GimenezCA/proyecto-mecatr-nica-gimenez/1000251209.jpg

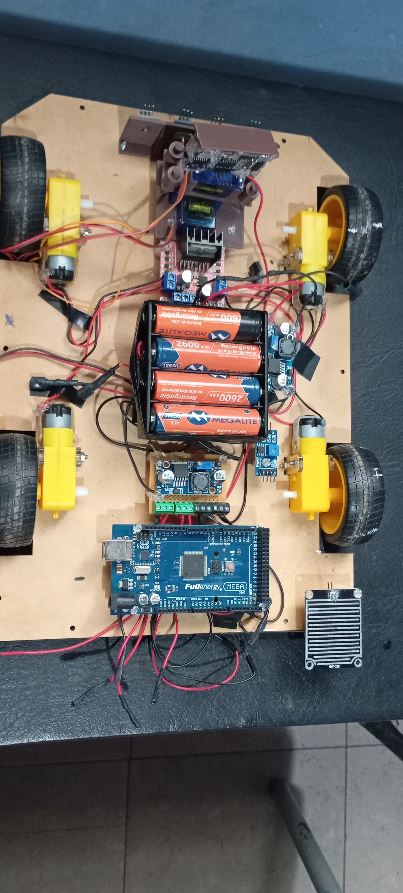
1000251209.jpg
