GimenezCA/proyecto-mecatr-nica-gimenez/1000251601.jpg

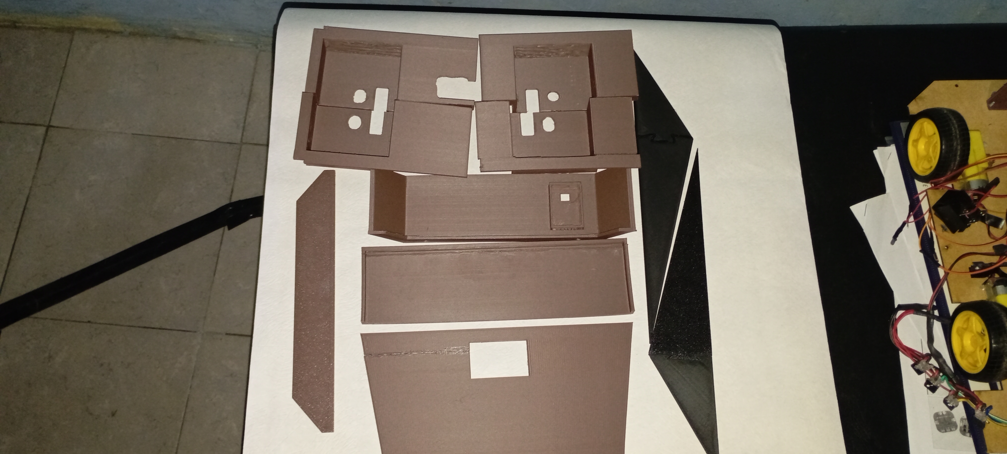
1000251601.jpg
