GimenezCA/proyecto-mecatr-nica-gimenez/README.md

# proyecto-mecatr-nica-gimenez



## Vehículo de vigilancia remoto



Vehiculo de pequeño para seguridad de predios, autonomo, con interfaz para visión y manejo por un usuario.
