GimenezCA/proyecto-mecatr-nica-gimenez/1000251196.jpg

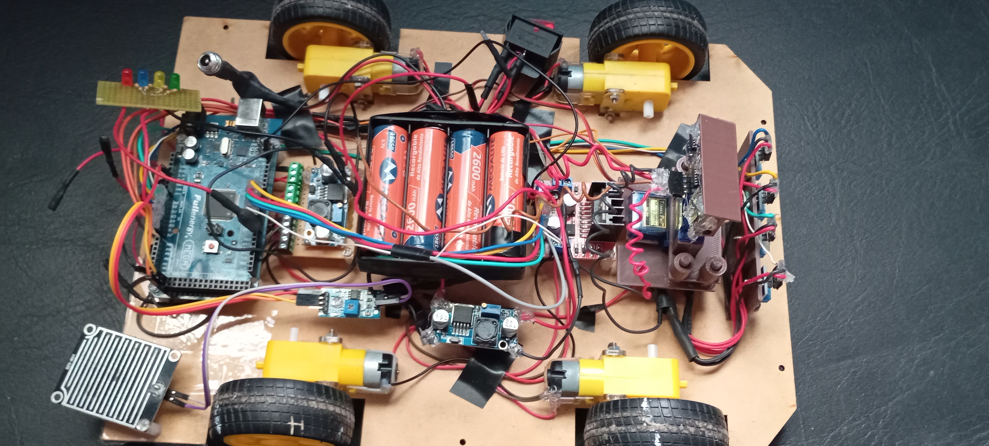
1000251196.jpg
