GimenezCA/proyecto-mecatr-nica-gimenez/1000251207 (1).jpg

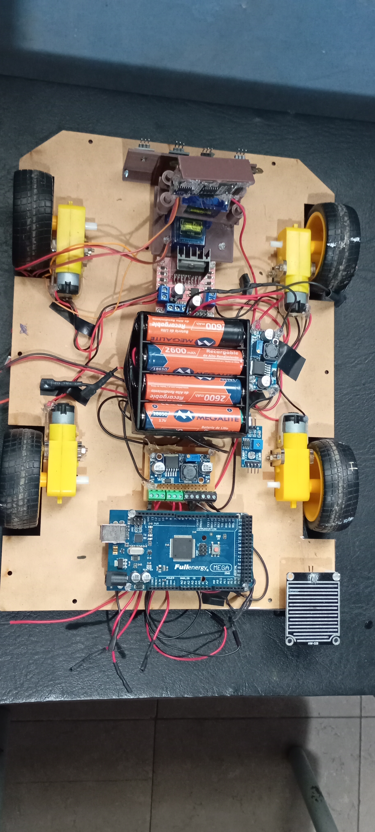
1000251207 (1).jpg
