GimenezCA/proyecto-mecatr-nica-gimenez/IMG-20250530-WA0015.jpg

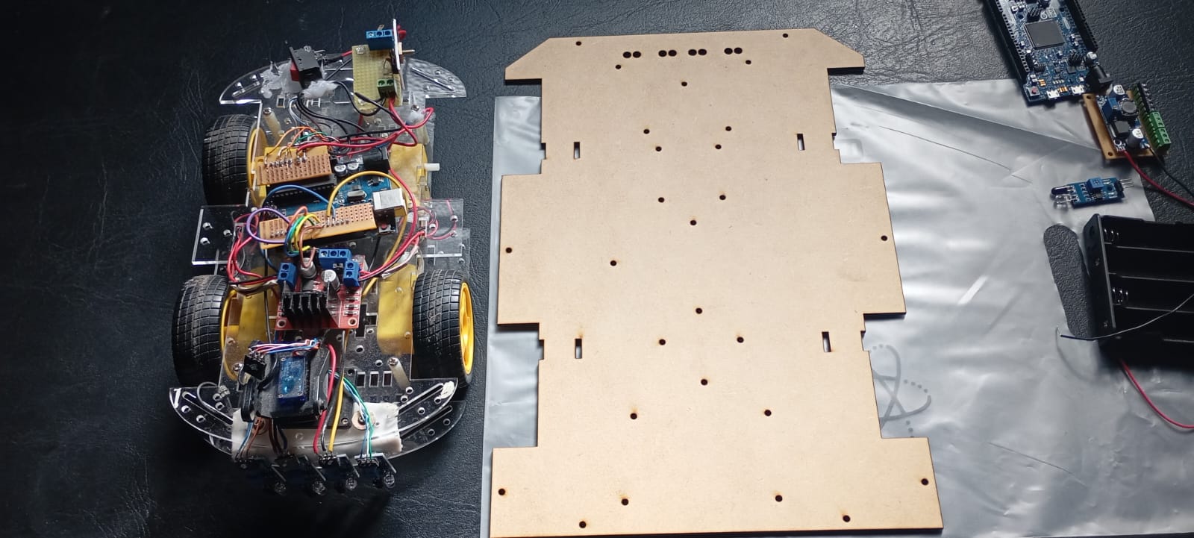
IMG-20250530-WA0015.jpg
