GimenezCA/proyecto-mecatr-nica-gimenez/IMG-20250530-WA0023.jpeg

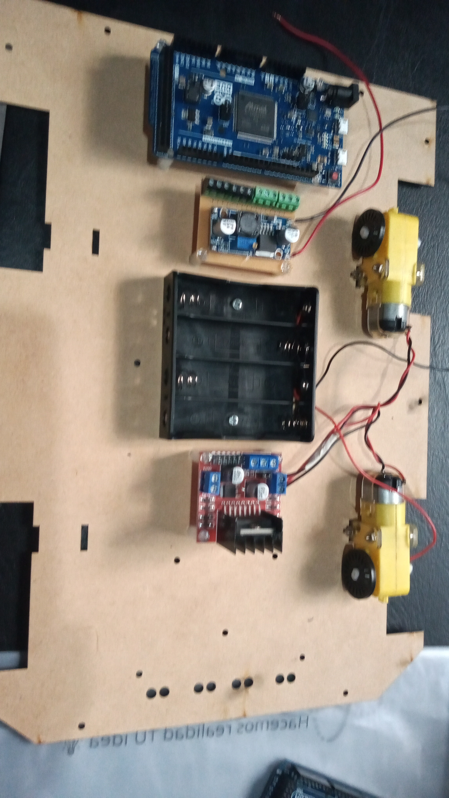
IMG-20250530-WA0023.jpeg
