GimenezCA/proyecto-mecatr-nica-gimenez/IMG_20221026_105854754.jpg

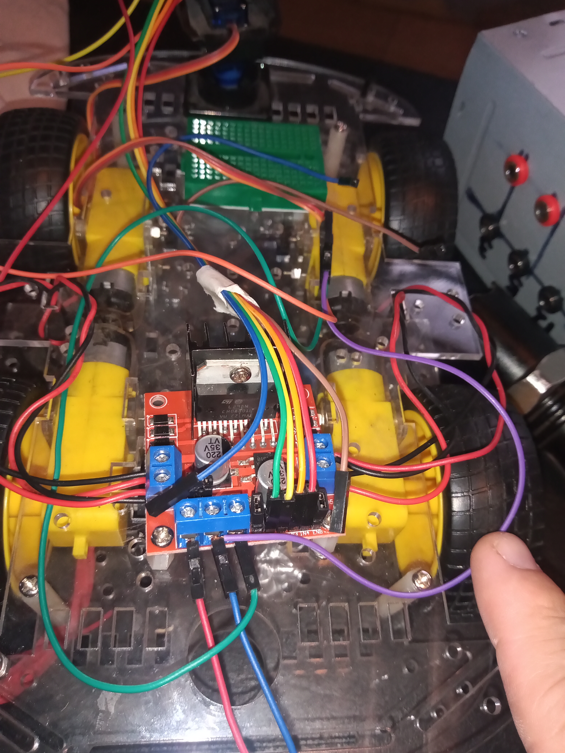
IMG_20221026_105854754.jpg
