GimenezCA/proyecto-mecatr-nica-gimenez/IMG_20221026_125409257.jpg

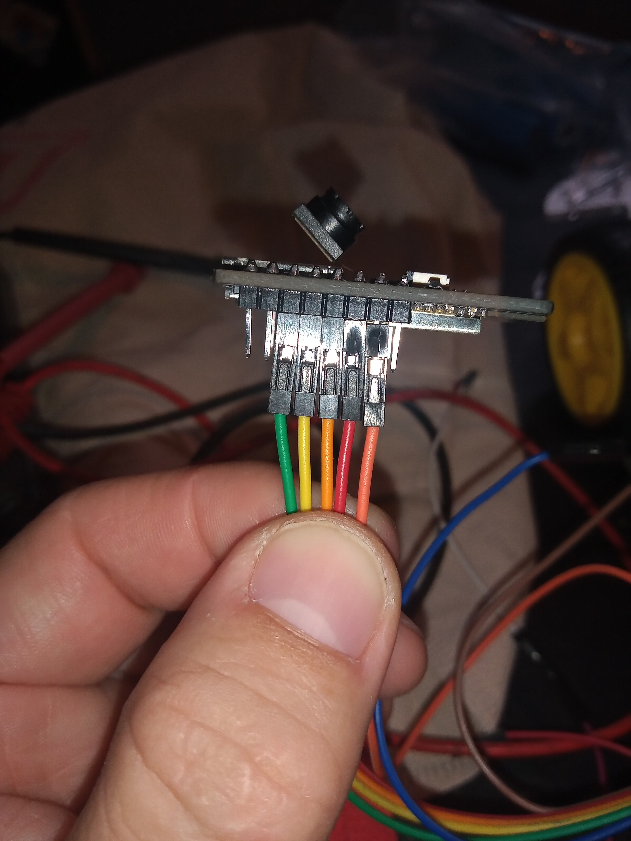
IMG_20221026_125409257.jpg
