GimenezCA/proyecto-mecatr-nica-gimenez/IMG_20250531_104836443.jpg

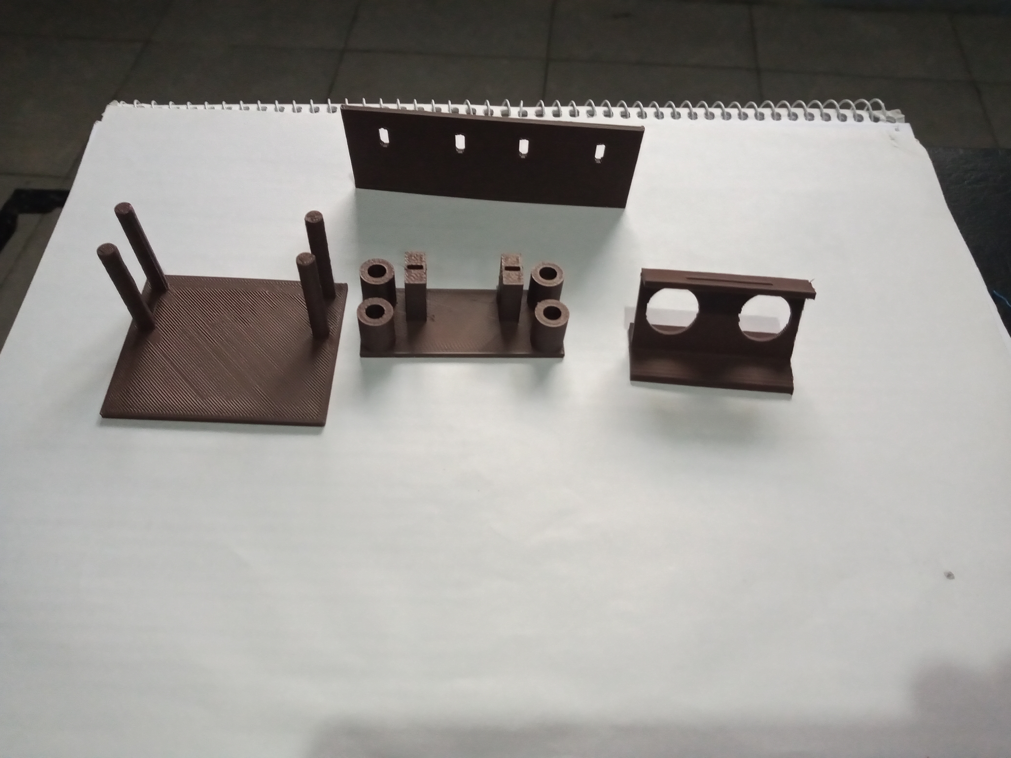
IMG_20250531_104836443.jpg
