GimenezCA/proyecto-mecatr-nica-gimenez/II-Planos_vistas_cotas_placabase_carcasa_conjuntoelevador.pdf

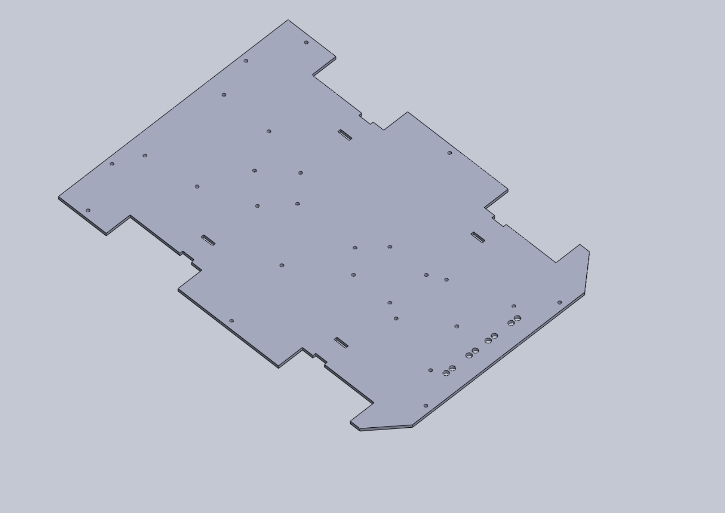
[picture p69: page 1]
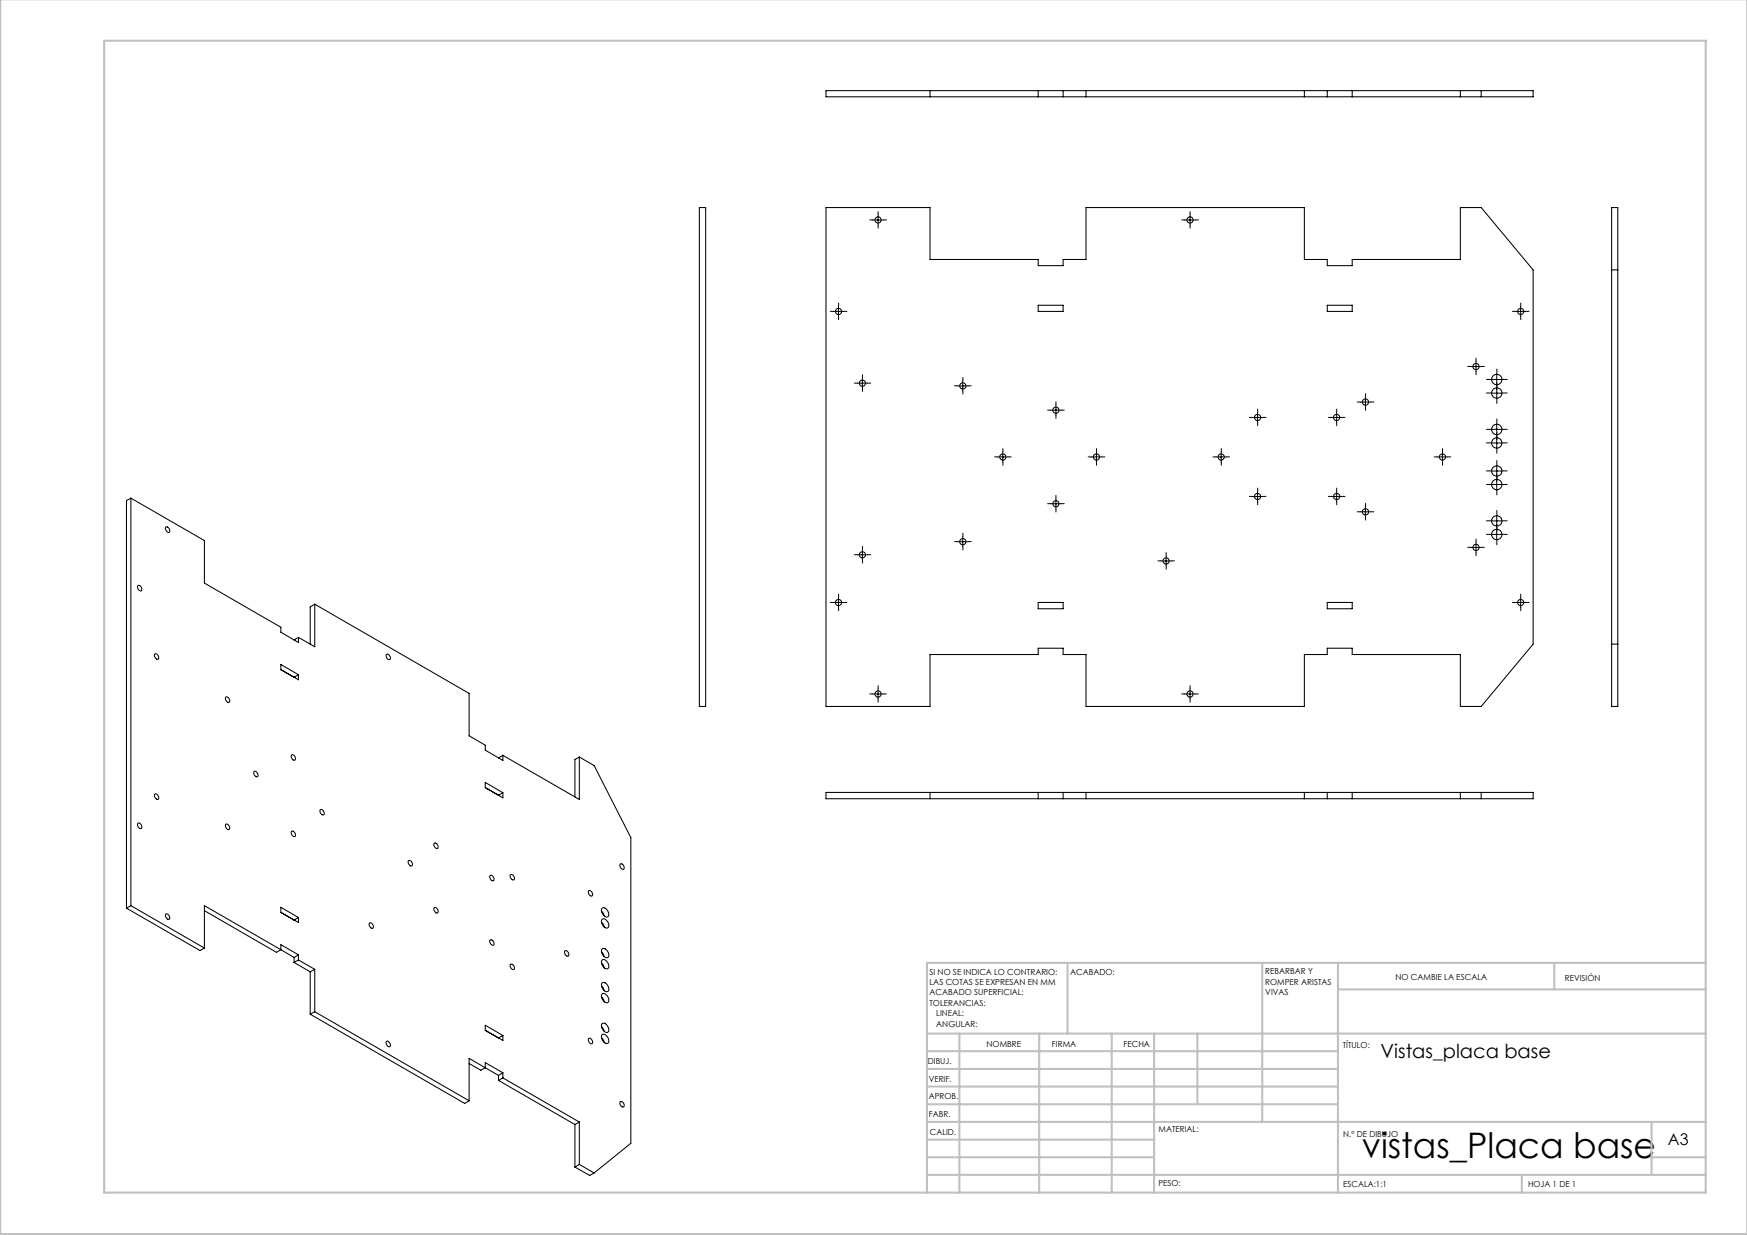
[picture p70: page 2]
ESCALA:1:1; HOJA 1 DE 1; NO CAMBIE LA ESCALA; REVISIÓN; REBARBAR Y ROMPER ARISTAS VIVAS; SI NO SE INDICA LO CONTRARIO:; ACABADO:

LAS COTAS SE EXPRESAN EN MM
ACABADO SUPERFICIAL:
TOLERANCIAS:
LINEAL:
ANGULAR:

NOMBRE | FIRMA | FECHA | | | | TÍTULO: Vistas_placa base
CALID. | | | | MATERIAL: | vistas_Placa base PESO: N.º DE DIBUJO | A3

DIBUJ.
VERIF.
APROB.
FABR.

50 52

12

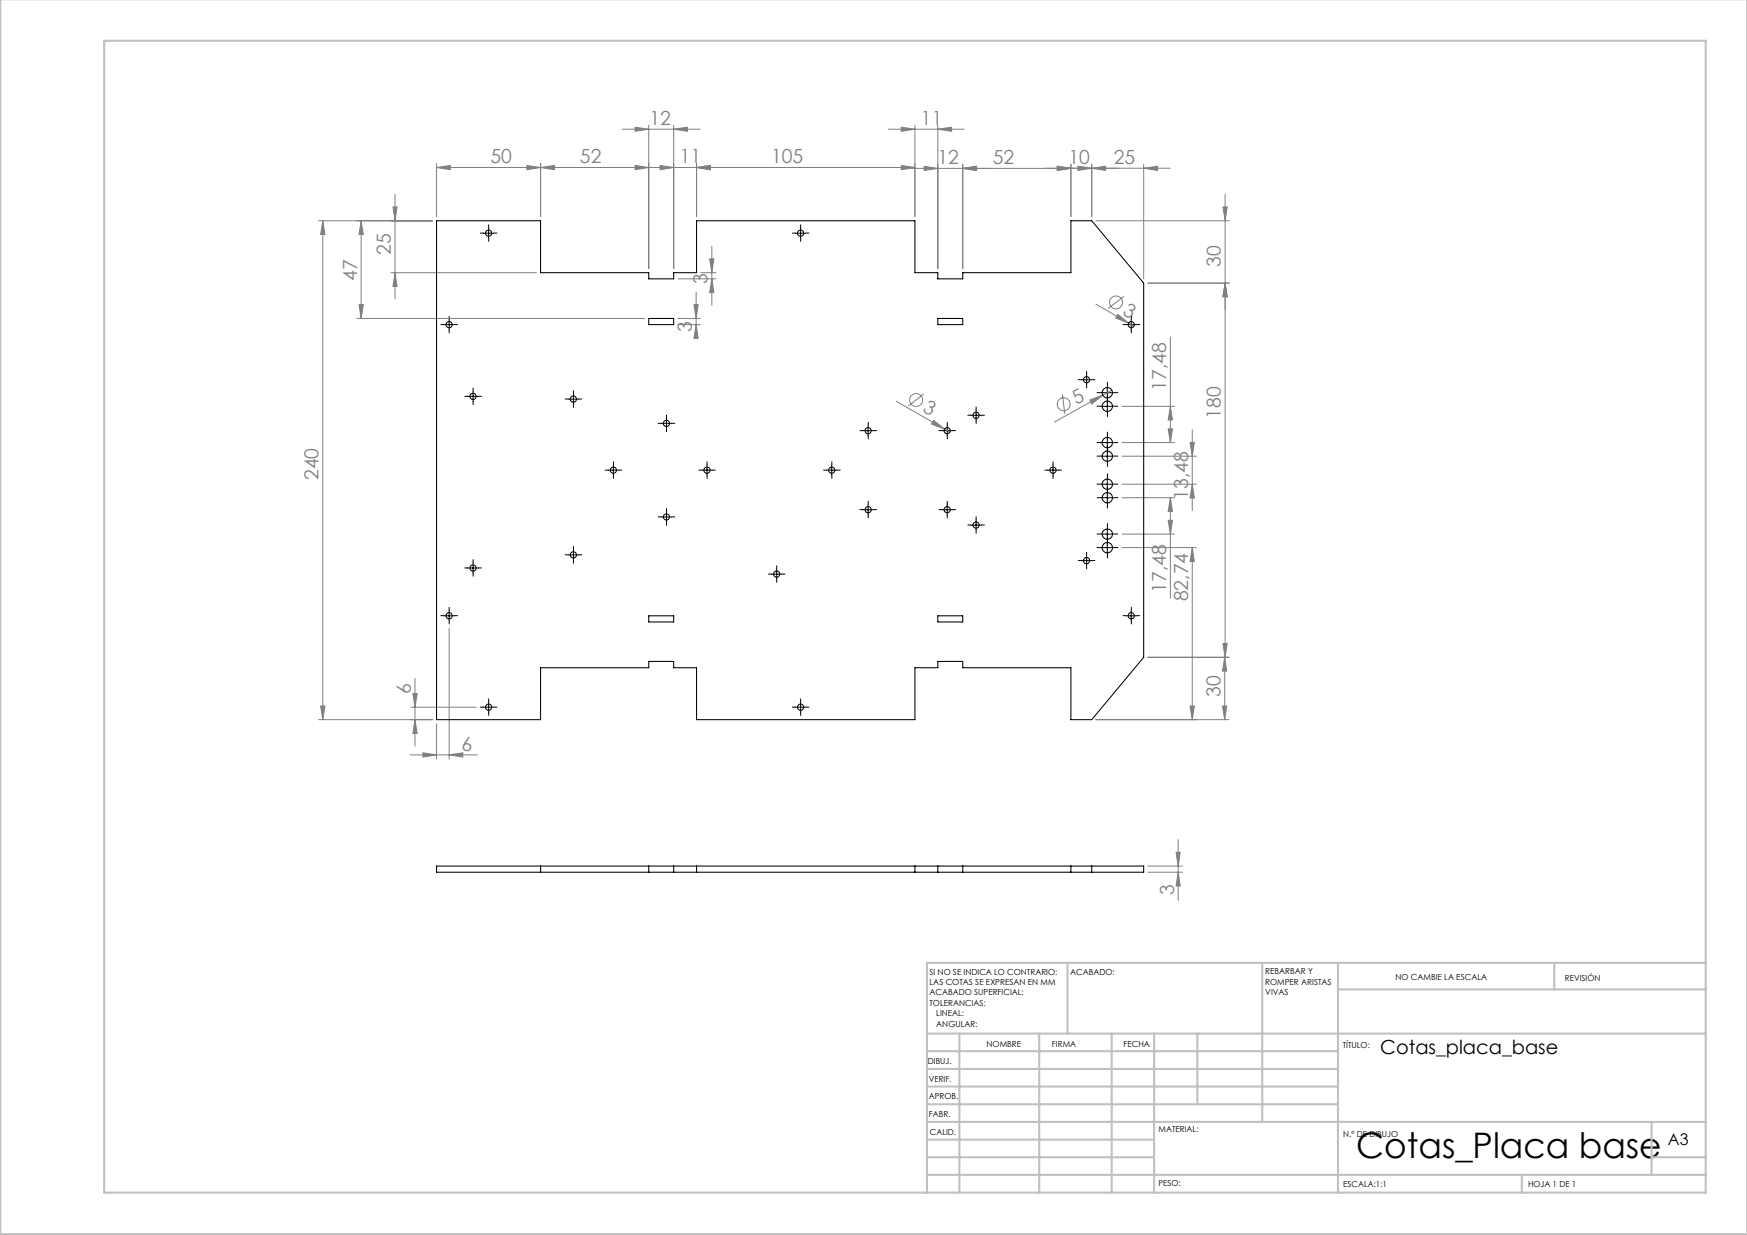
[picture p71: page 3]
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

LAS COTAS SE EXPRESAN EN MM
ACABADO SUPERFICIAL:
TOLERANCIAS:
LINEAL:
ANGULAR:

NOMBRE | FIRMA | FECHA | | | Cotas_placa_base TÍTULO:

DIBUJ.
VERIF.
APROB.
FABR.

MATERIAL: | Cotas_Placa base PESO:

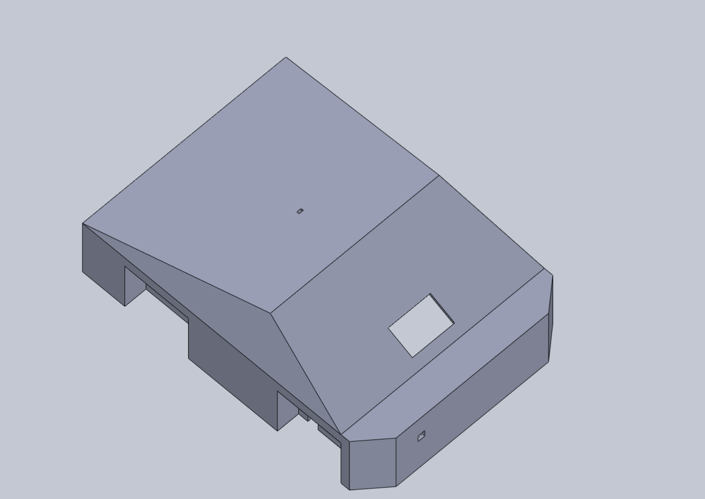
[picture p72: page 4]
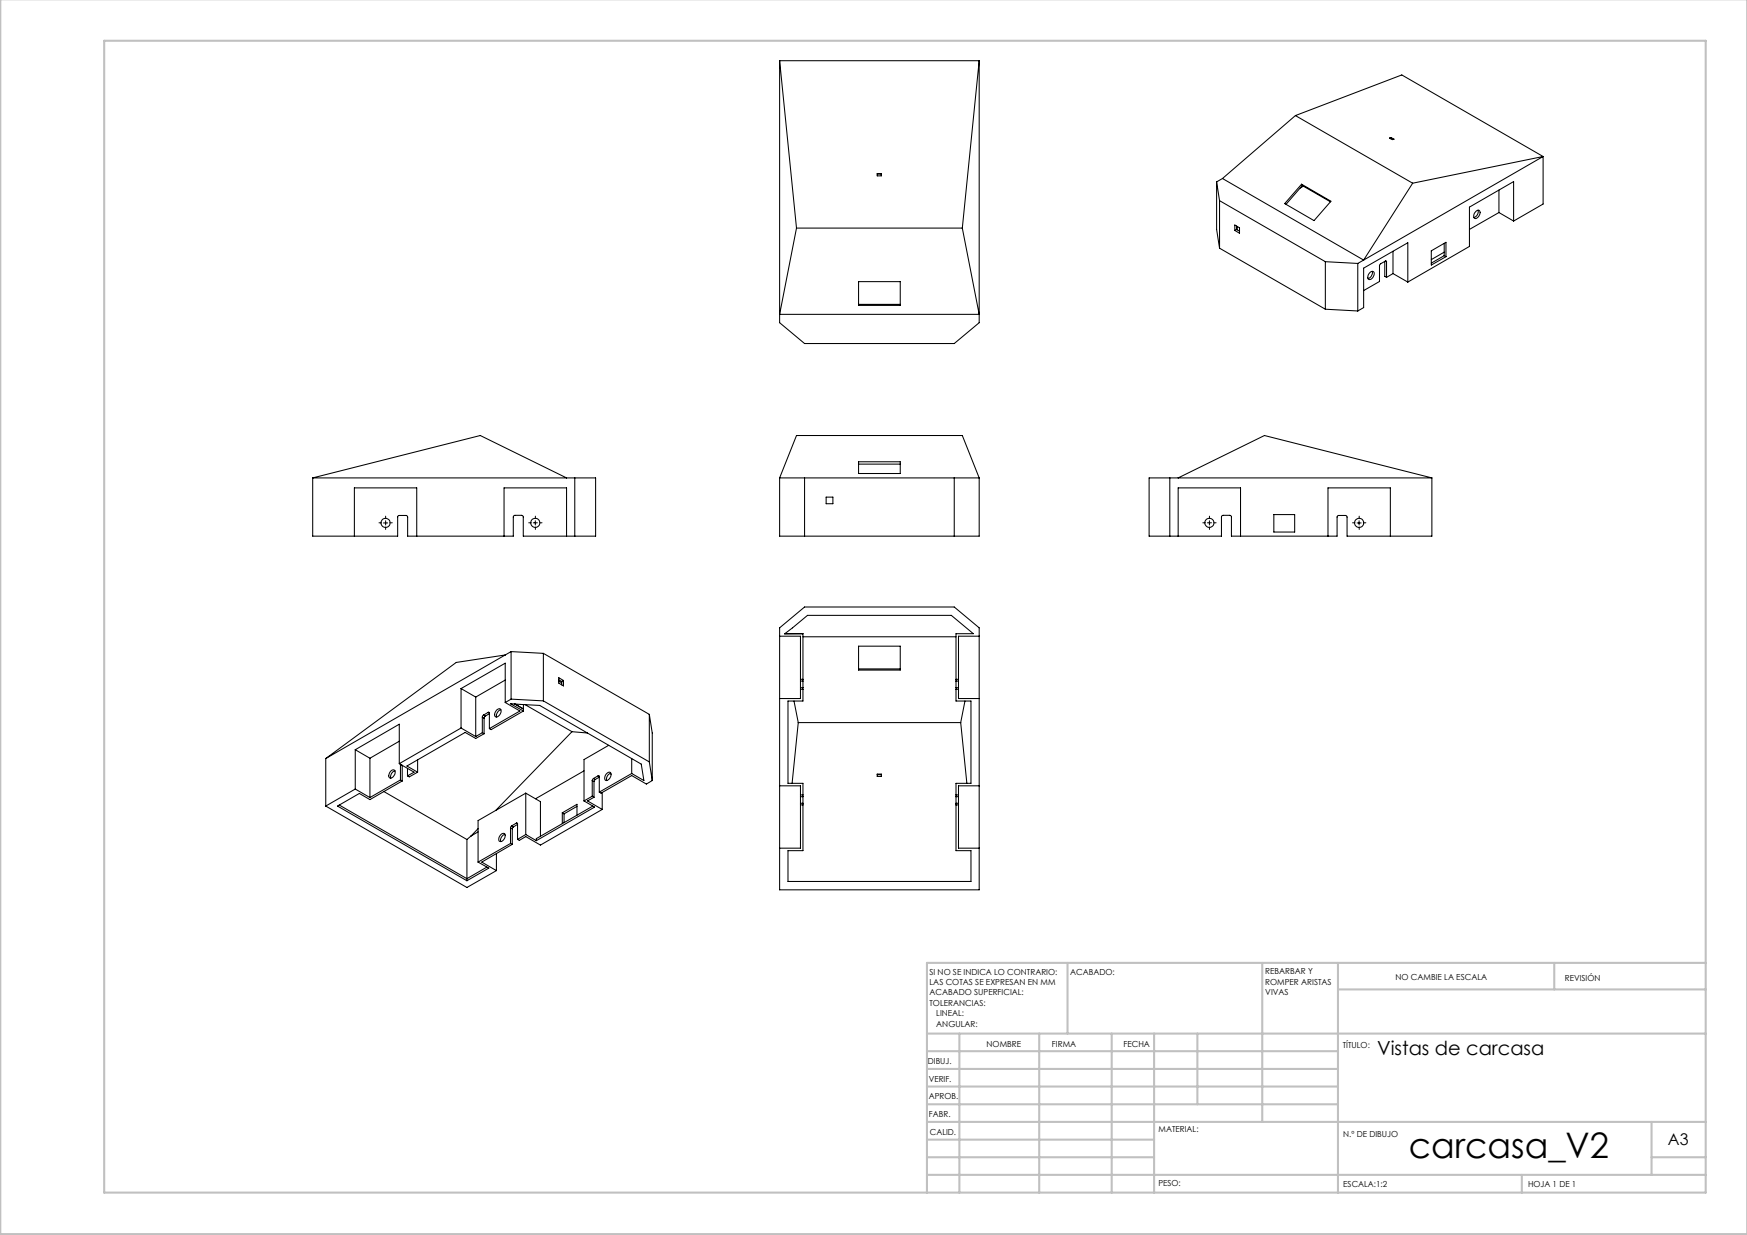
[picture p73: page 5]
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

LAS COTAS SE EXPRESAN EN MM
ACABADO SUPERFICIAL:
TOLERANCIAS:
LINEAL:
ANGULAR:

NOMBRE | FIRMA | FECHA | | | | Vistas de carcasa TÍTULO:

DIBUJ.
VERIF.
APROB.
FABR.

MATERIAL: | carcasa_V2 PESO:

ESCALA:1:2 | HOJA 1 DE 1

20,40 | 199,20 | 20,40

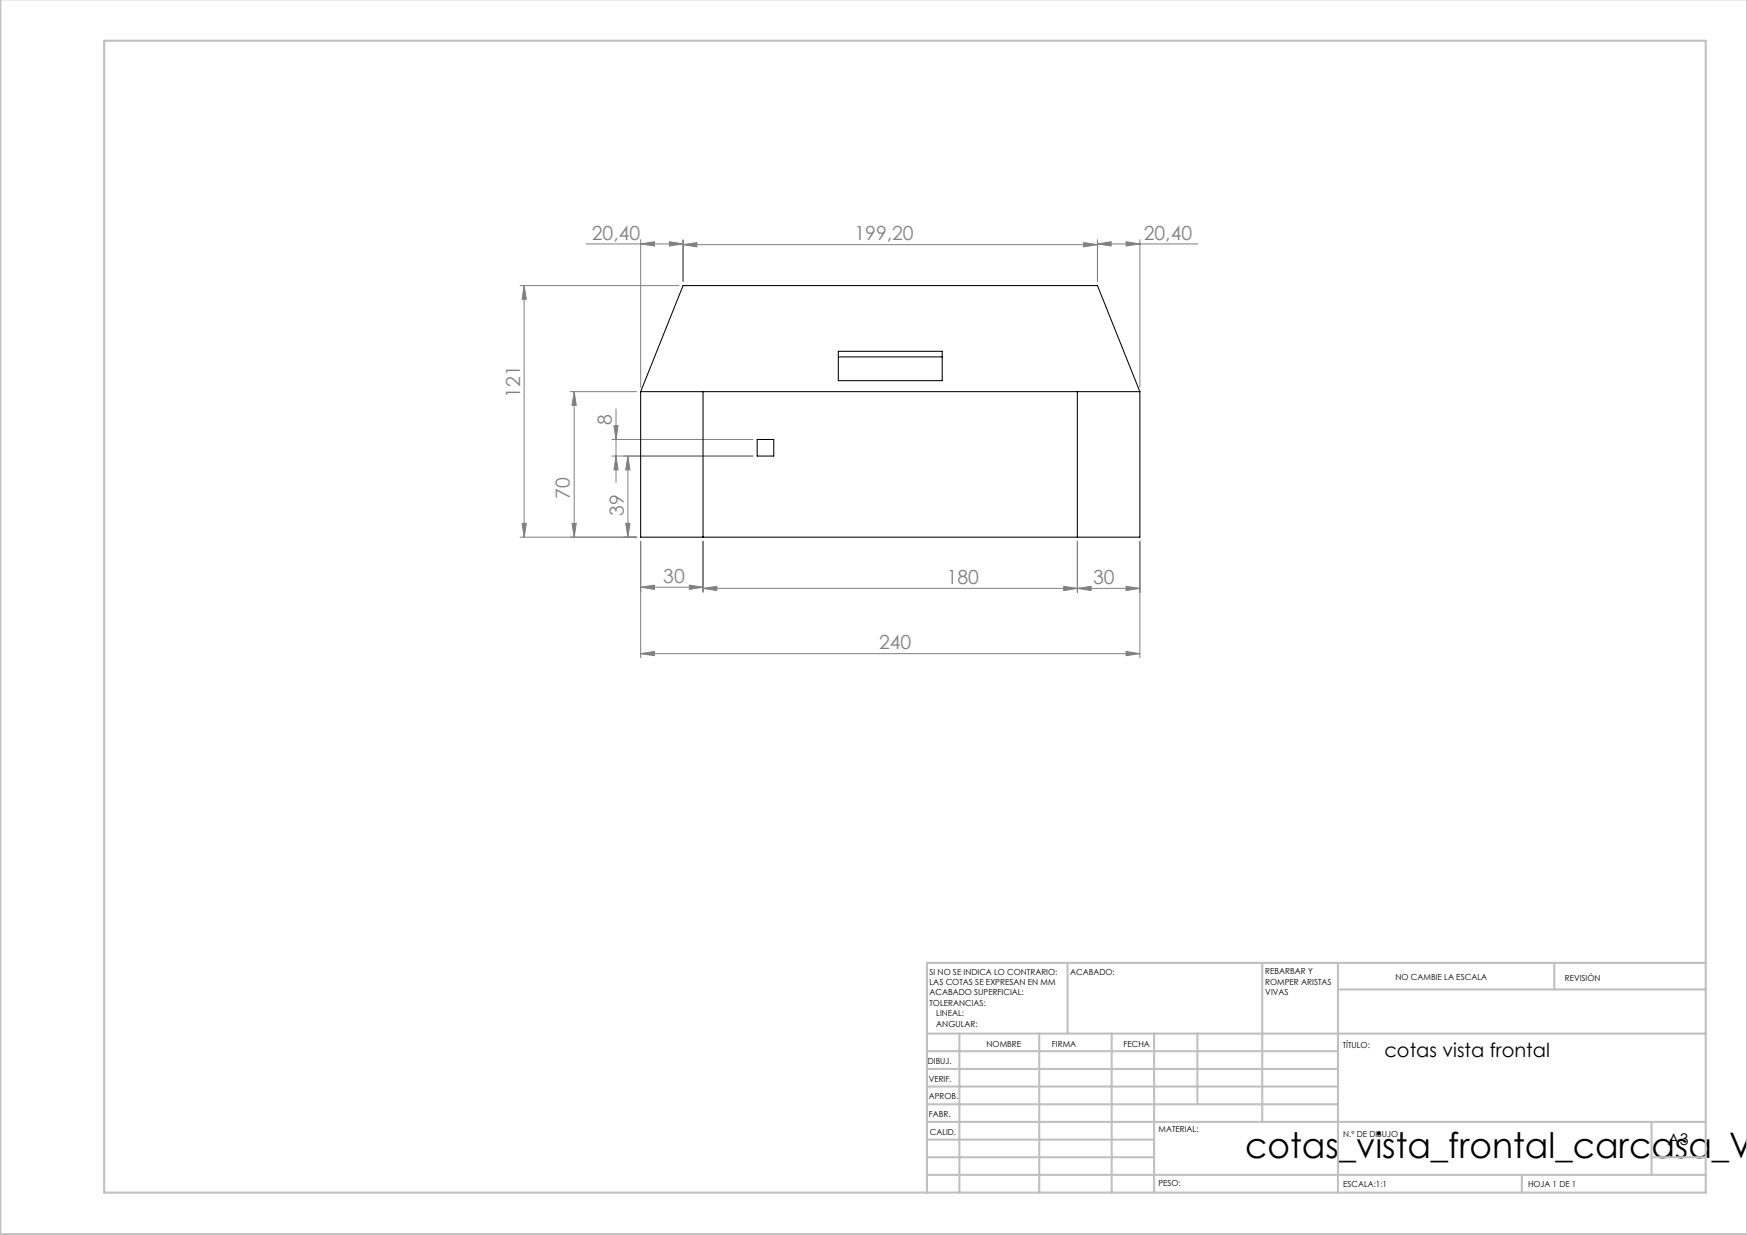
[picture p74: page 6]
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

LAS COTAS SE EXPRESAN EN MM
ACABADO SUPERFICIAL:
TOLERANCIAS:
LINEAL:
ANGULAR:

NOMBRE | FIRMA | FECHA | | TÍTULO: cotas vista frontal

DIBUJ.
VERIF.
APROB.
FABR.

MATERIAL: cotas_vista_frontal_carcasa_V2 PESO:

10

102

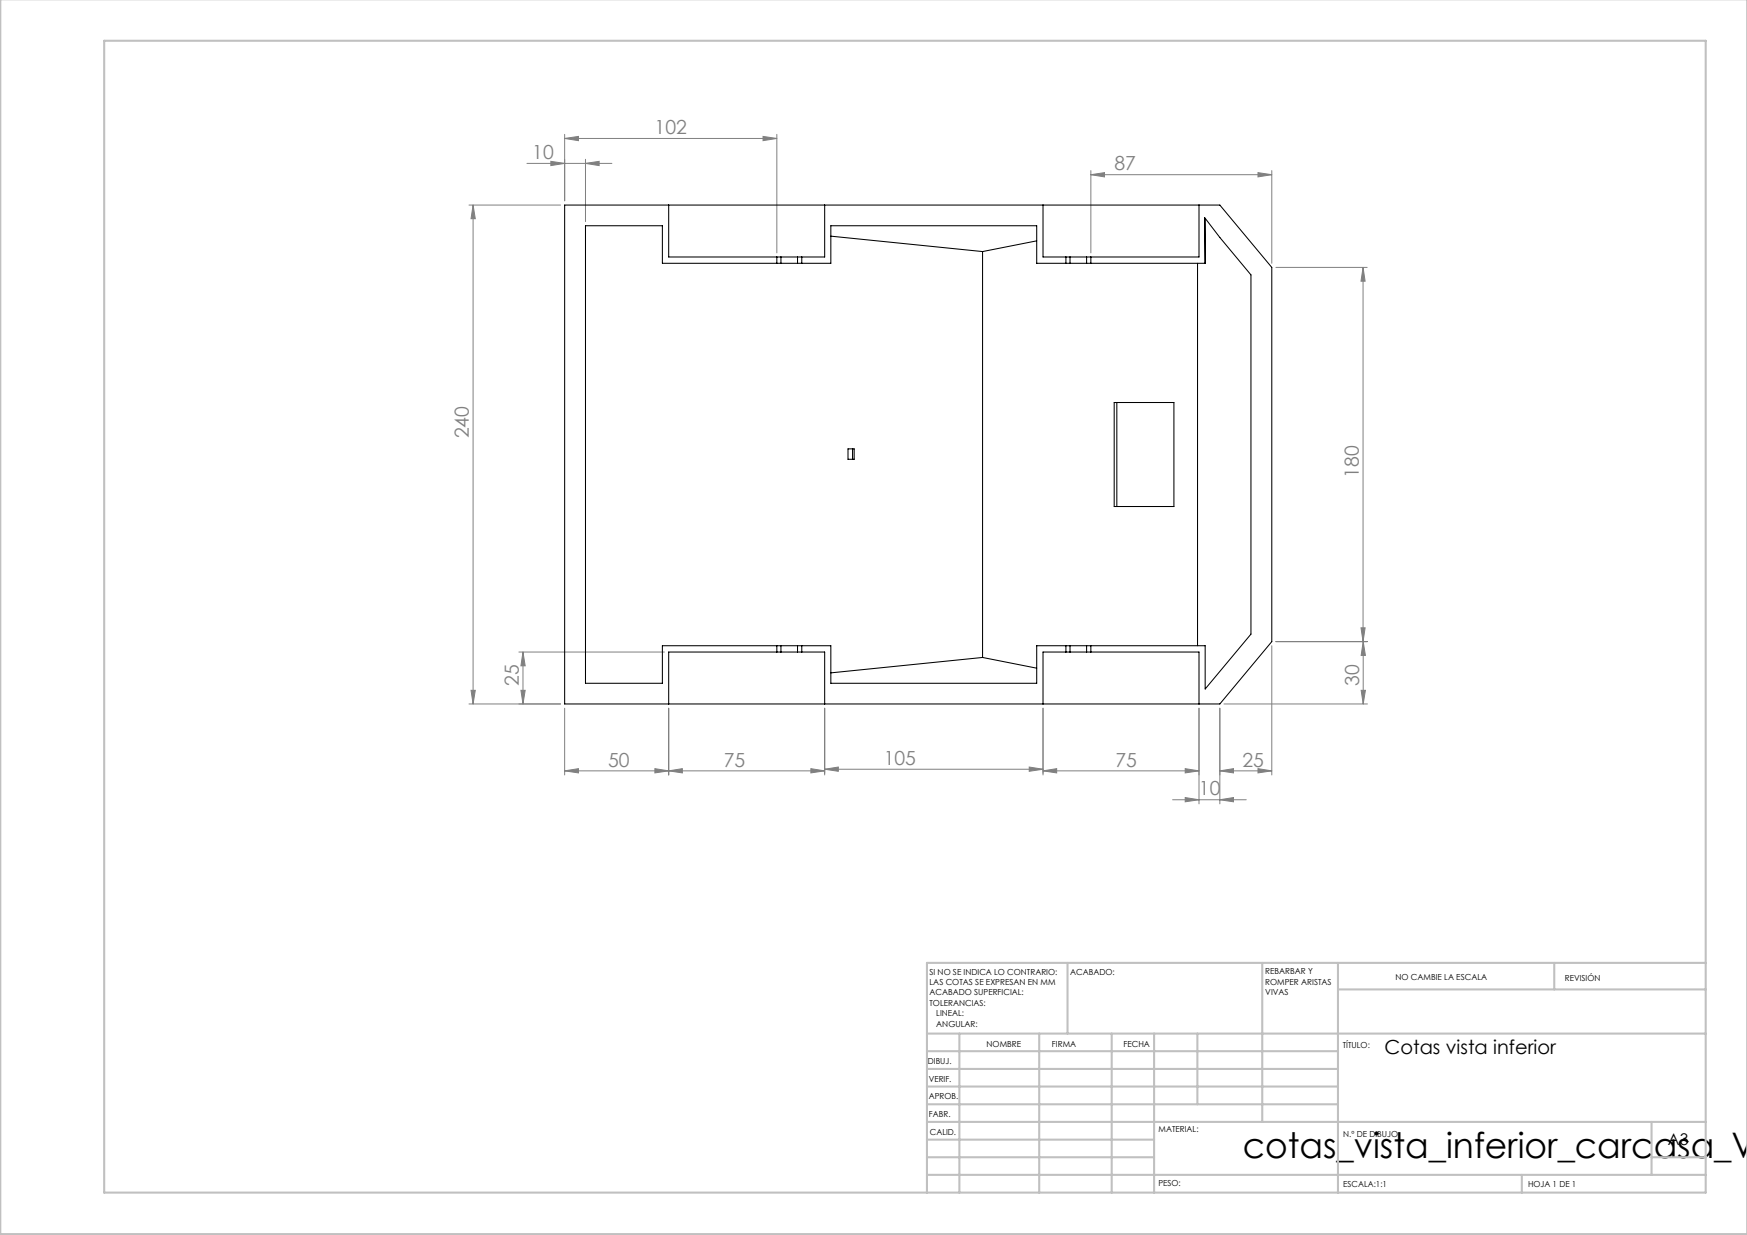
[picture p75: page 7]
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

LAS COTAS SE EXPRESAN EN MM
ACABADO SUPERFICIAL:
TOLERANCIAS:
LINEAL:
ANGULAR:

NOMBRE | FIRMA | FECHA | | Cotas vista inferior TÍTULO:

DIBUJ.
VERIF.
APROB.
FABR.

MATERIAL: cotas_vista_inferior_carcasa_V2 PESO:

35 | 103,70 | 201,30

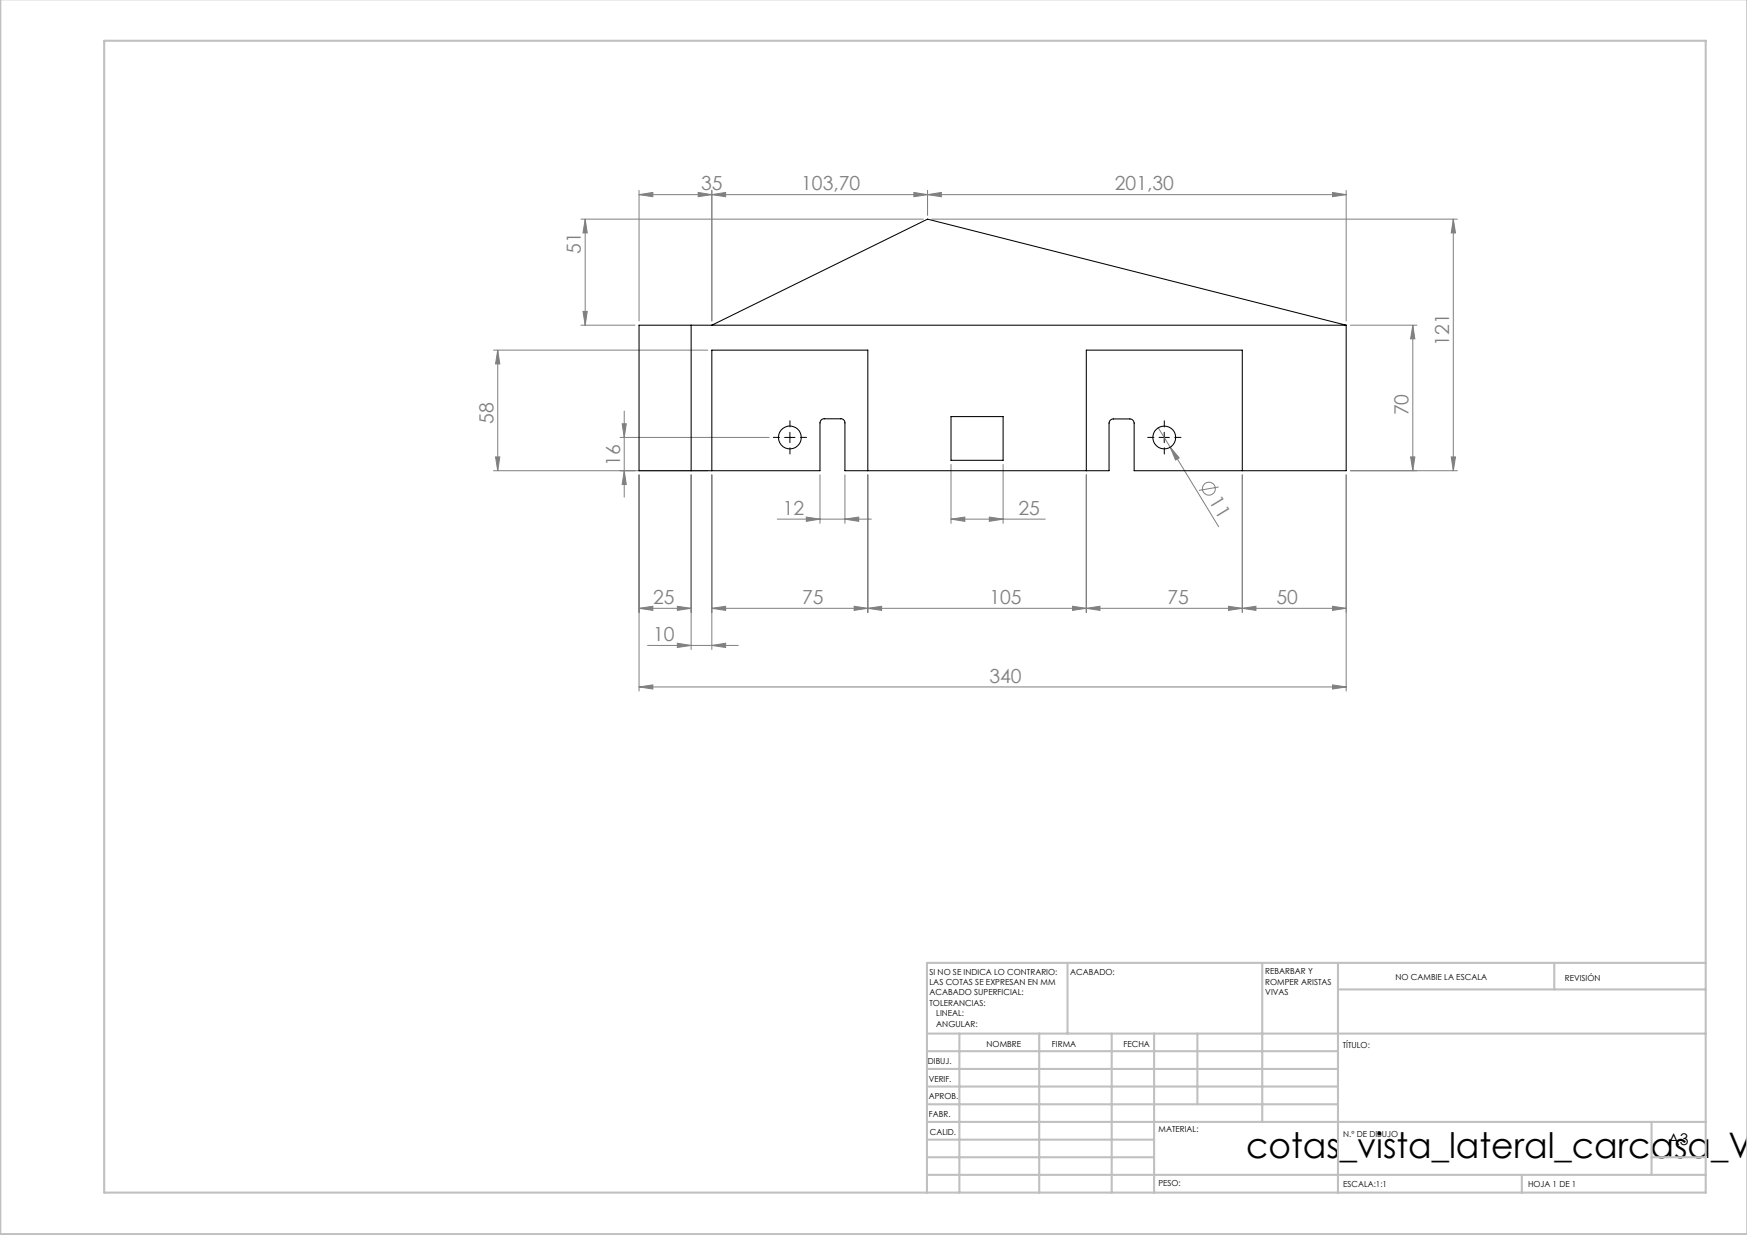
[picture p76: page 8]
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

LAS COTAS SE EXPRESAN EN MM
ACABADO SUPERFICIAL:
TOLERANCIAS:
LINEAL:
ANGULAR:

NOMBRE | FIRMA | FECHA | | TÍTULO:

DIBUJ.
VERIF.
APROB.
FABR.

MATERIAL: cotas_vista_lateral_carcasa_V2 PESO:

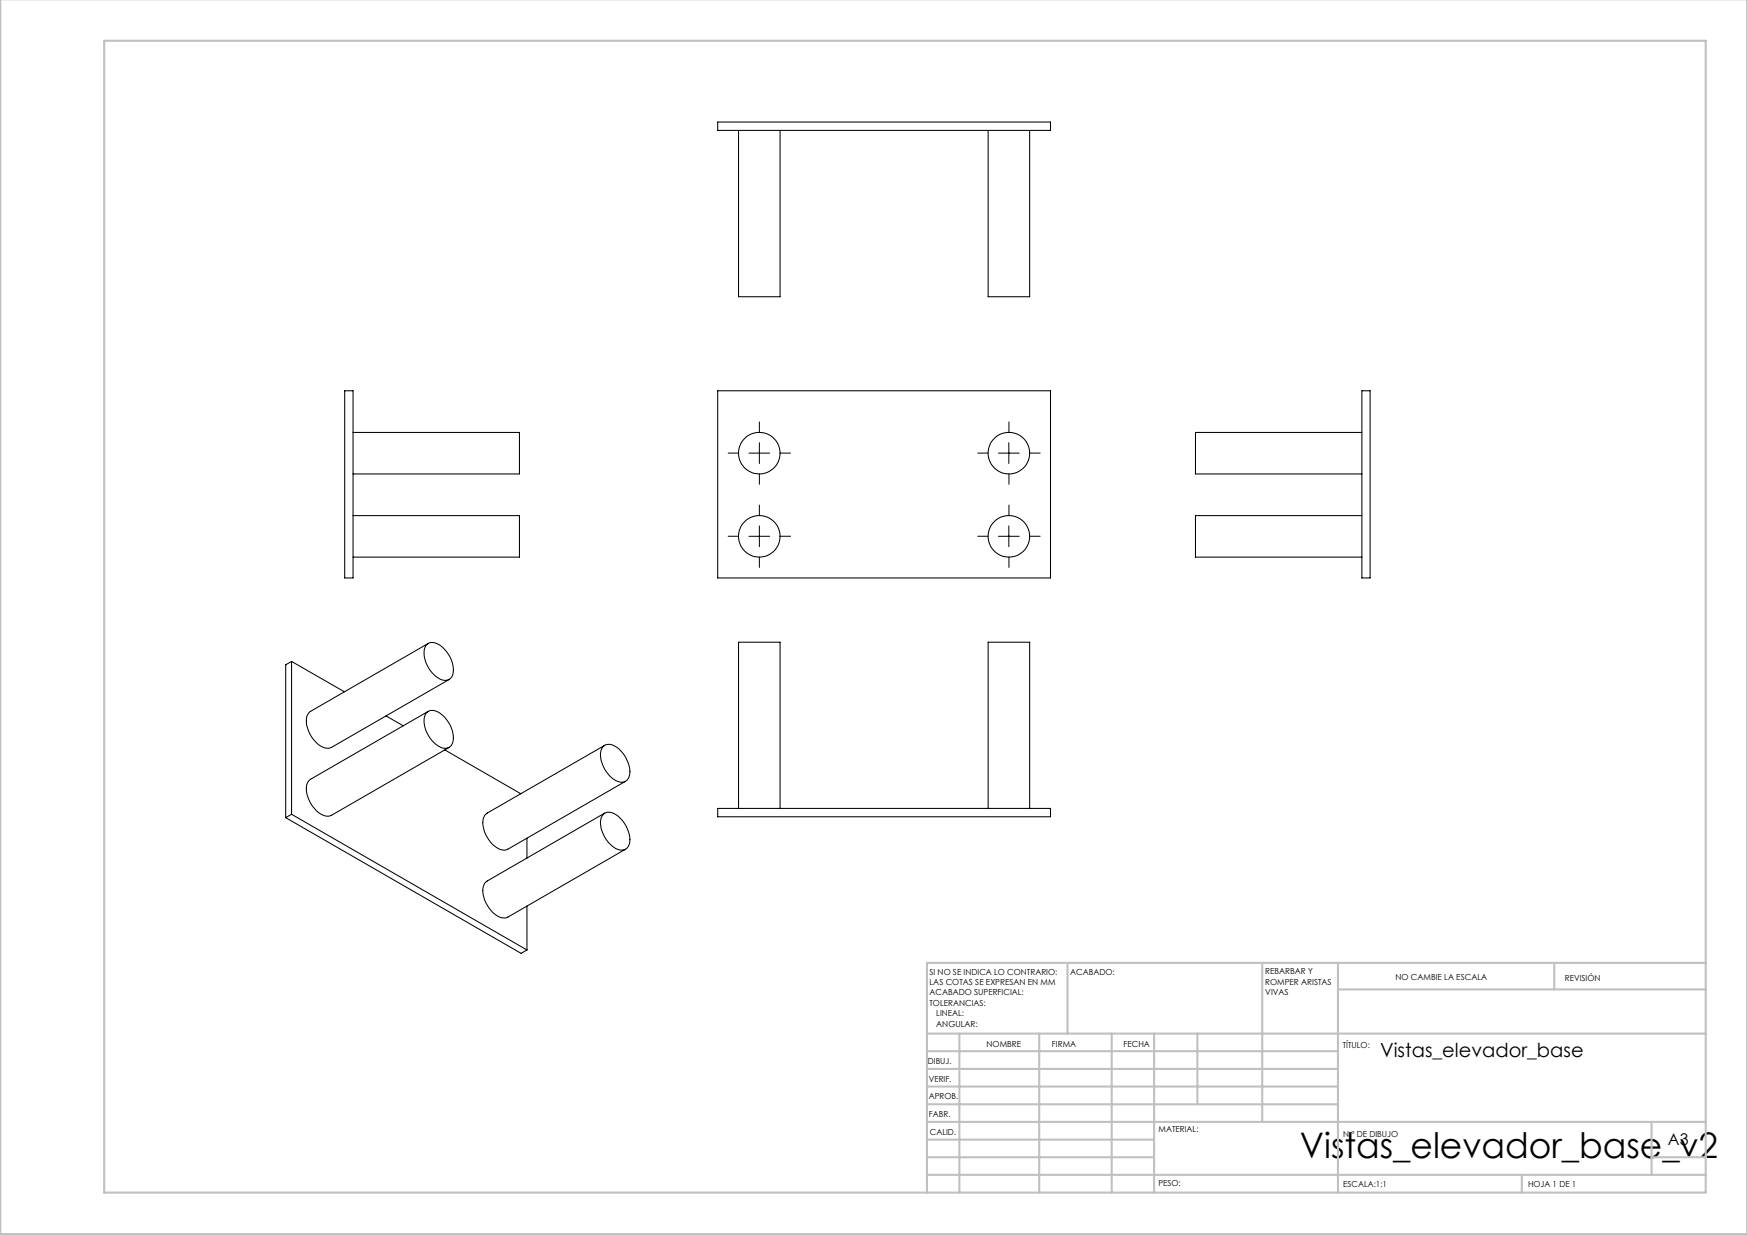
[picture p77: page 9]
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

LAS COTAS SE EXPRESAN EN MM
ACABADO SUPERFICIAL:
TOLERANCIAS:
LINEAL:
ANGULAR:

NOMBRE | FIRMA | FECHA | | TÍTULO: Vistas_elevador_base

DIBUJ.
VERIF.
APROB.
FABR.

MATERIAL: Vistas_elevador_base_v2 PESO:

60

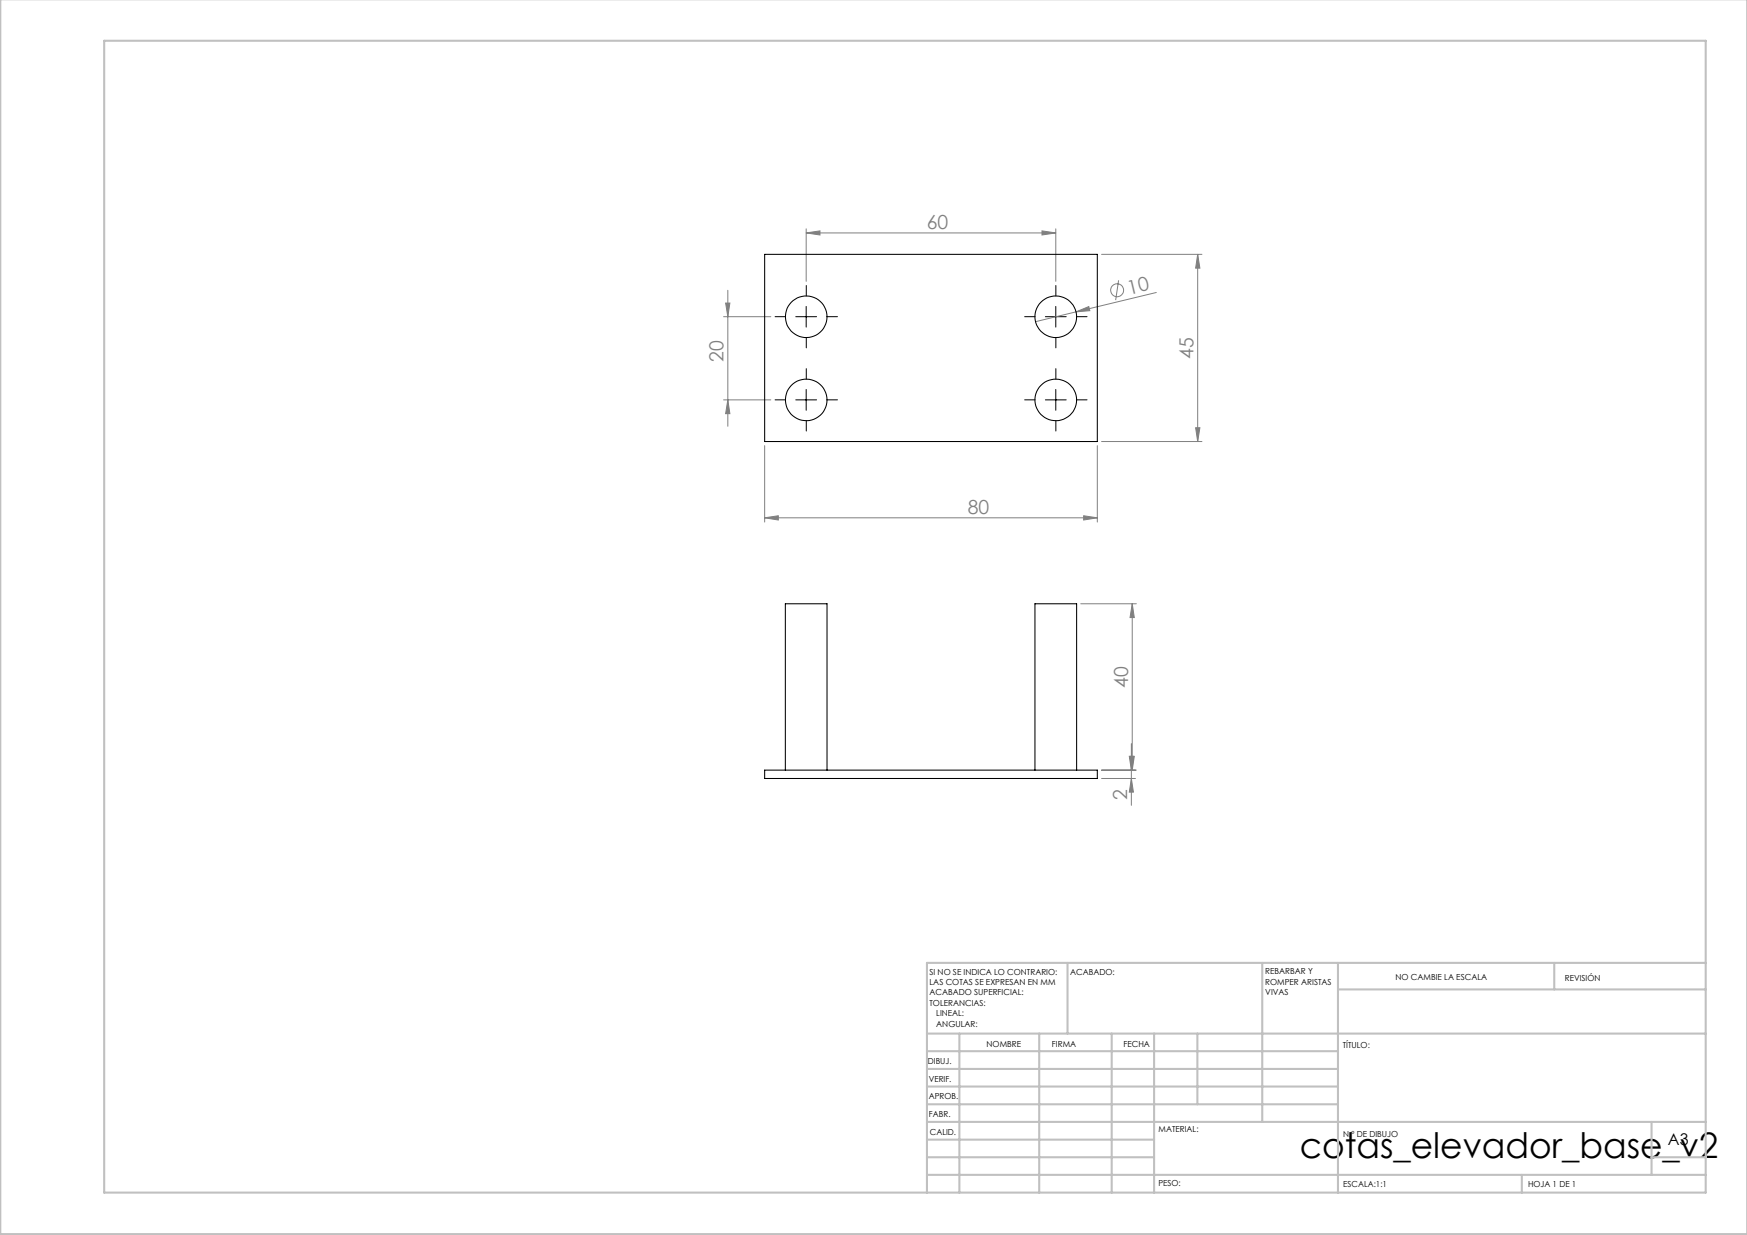
[picture p78: page 10]
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

LAS COTAS SE EXPRESAN EN MM
ACABADO SUPERFICIAL:
TOLERANCIAS:
LINEAL:
ANGULAR:

NOMBRE | FIRMA | FECHA | | TÍTULO:

DIBUJ.
VERIF.
APROB.
FABR.

MATERIAL: cotas_elevador_base_v2 PESO:

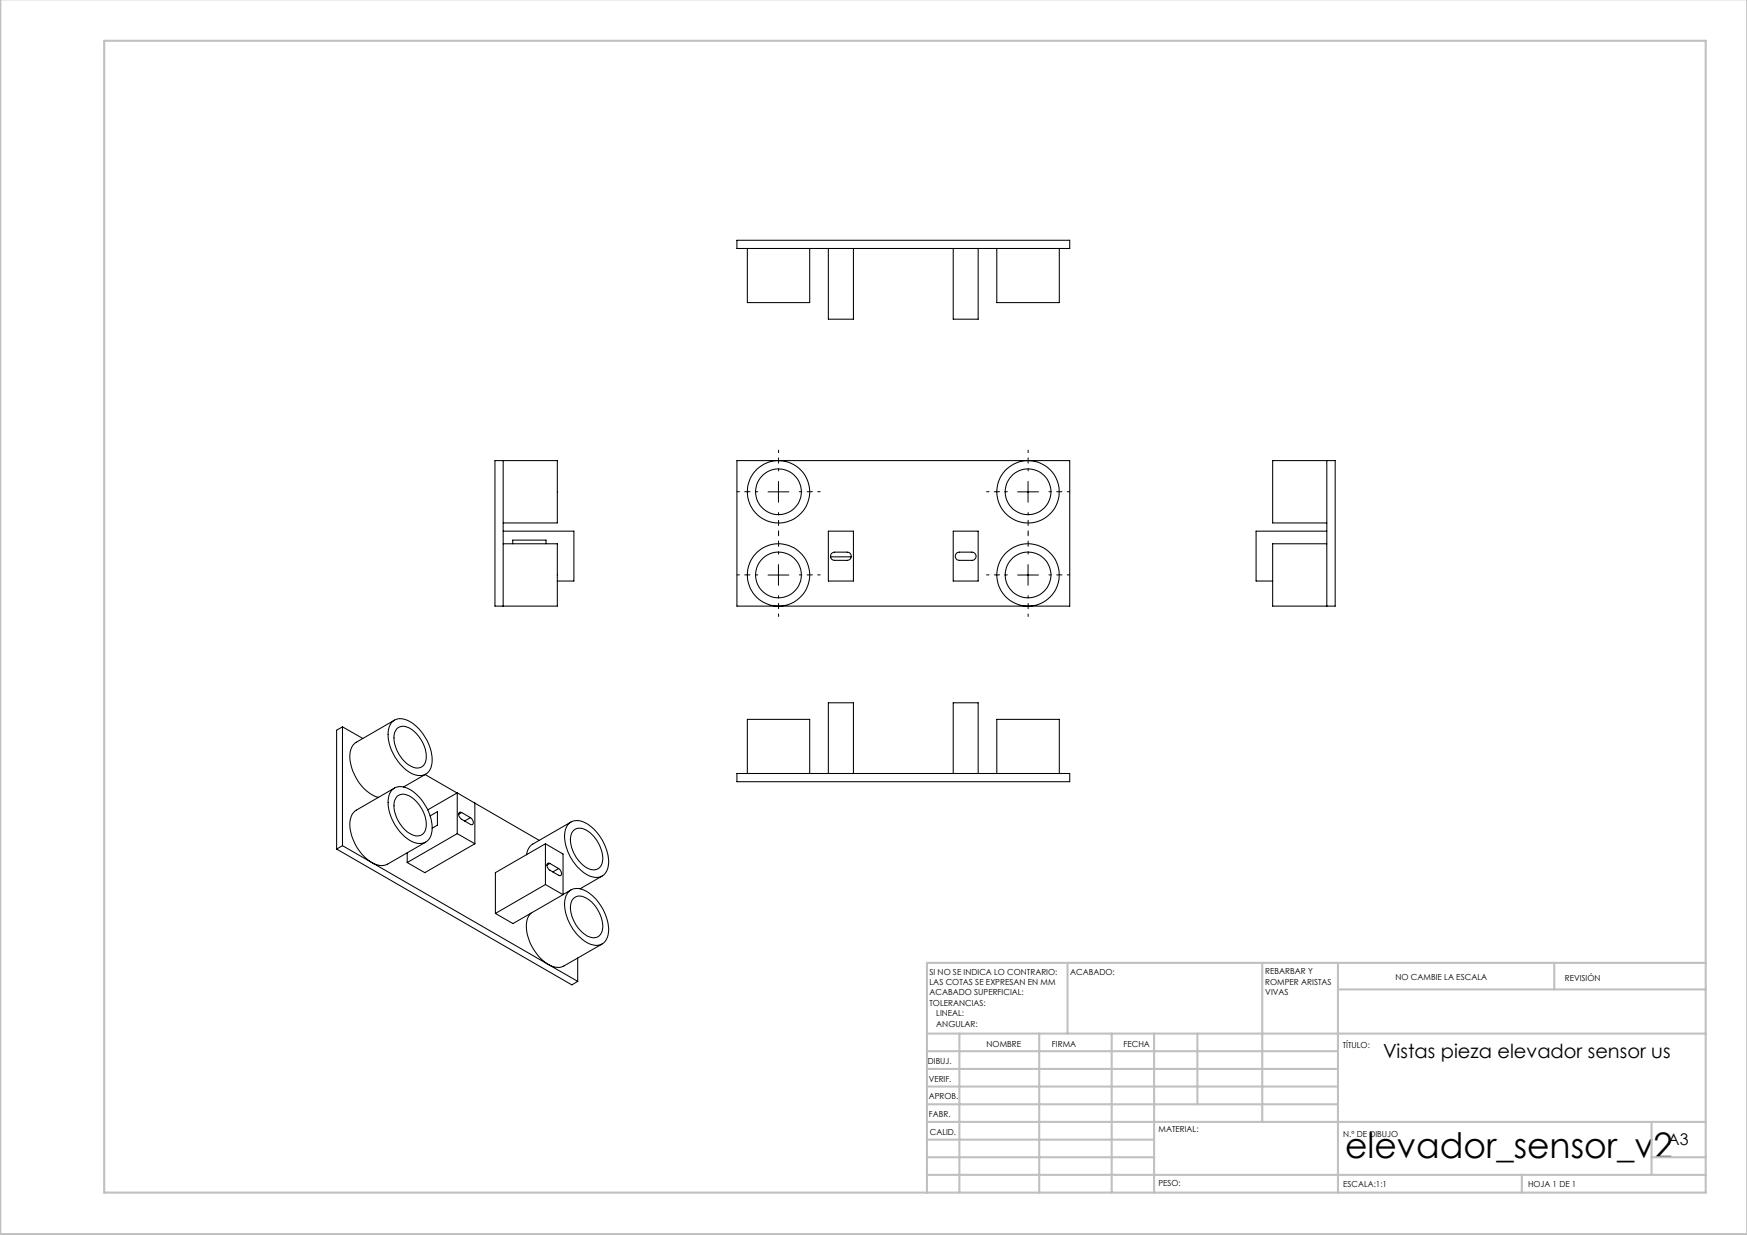
[picture p79: page 11]
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

LAS COTAS SE EXPRESAN EN MM
ACABADO SUPERFICIAL:
TOLERANCIAS:
LINEAL:
ANGULAR:

NOMBRE | FIRMA | FECHA | | | TÍTULO: Vistas pieza elevador sensor us

DIBUJ.
VERIF.
APROB.
FABR.

MATERIAL: | elevador_sensor_v2 PESO:

60

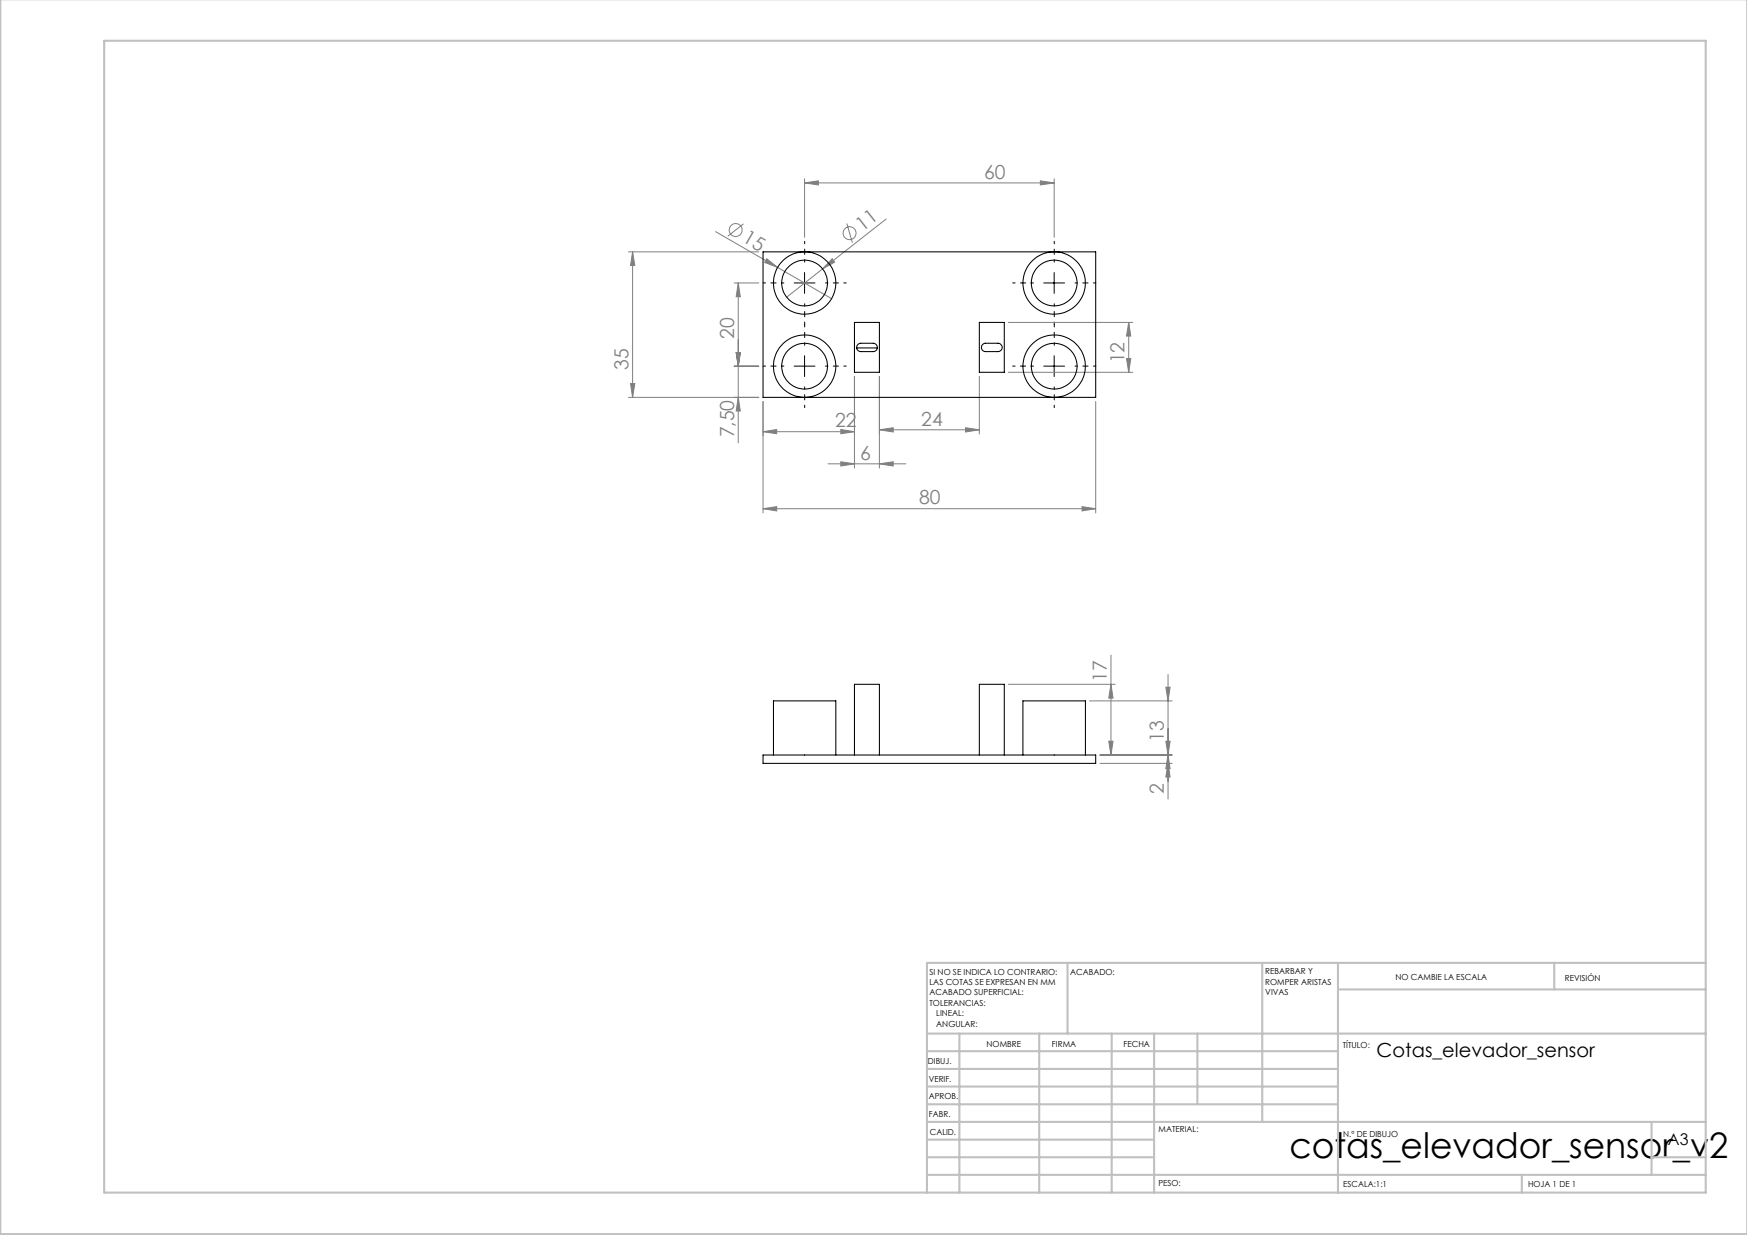
[picture p80: page 12]
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

LAS COTAS SE EXPRESAN EN MM
ACABADO SUPERFICIAL:
TOLERANCIAS:
LINEAL:
ANGULAR:

NOMBRE | FIRMA | FECHA | | Cotas_elevador_sensor TÍTULO:

DIBUJ.
VERIF.
APROB.
FABR.

MATERIAL: cotas_elevador_sensor_v2 PESO:

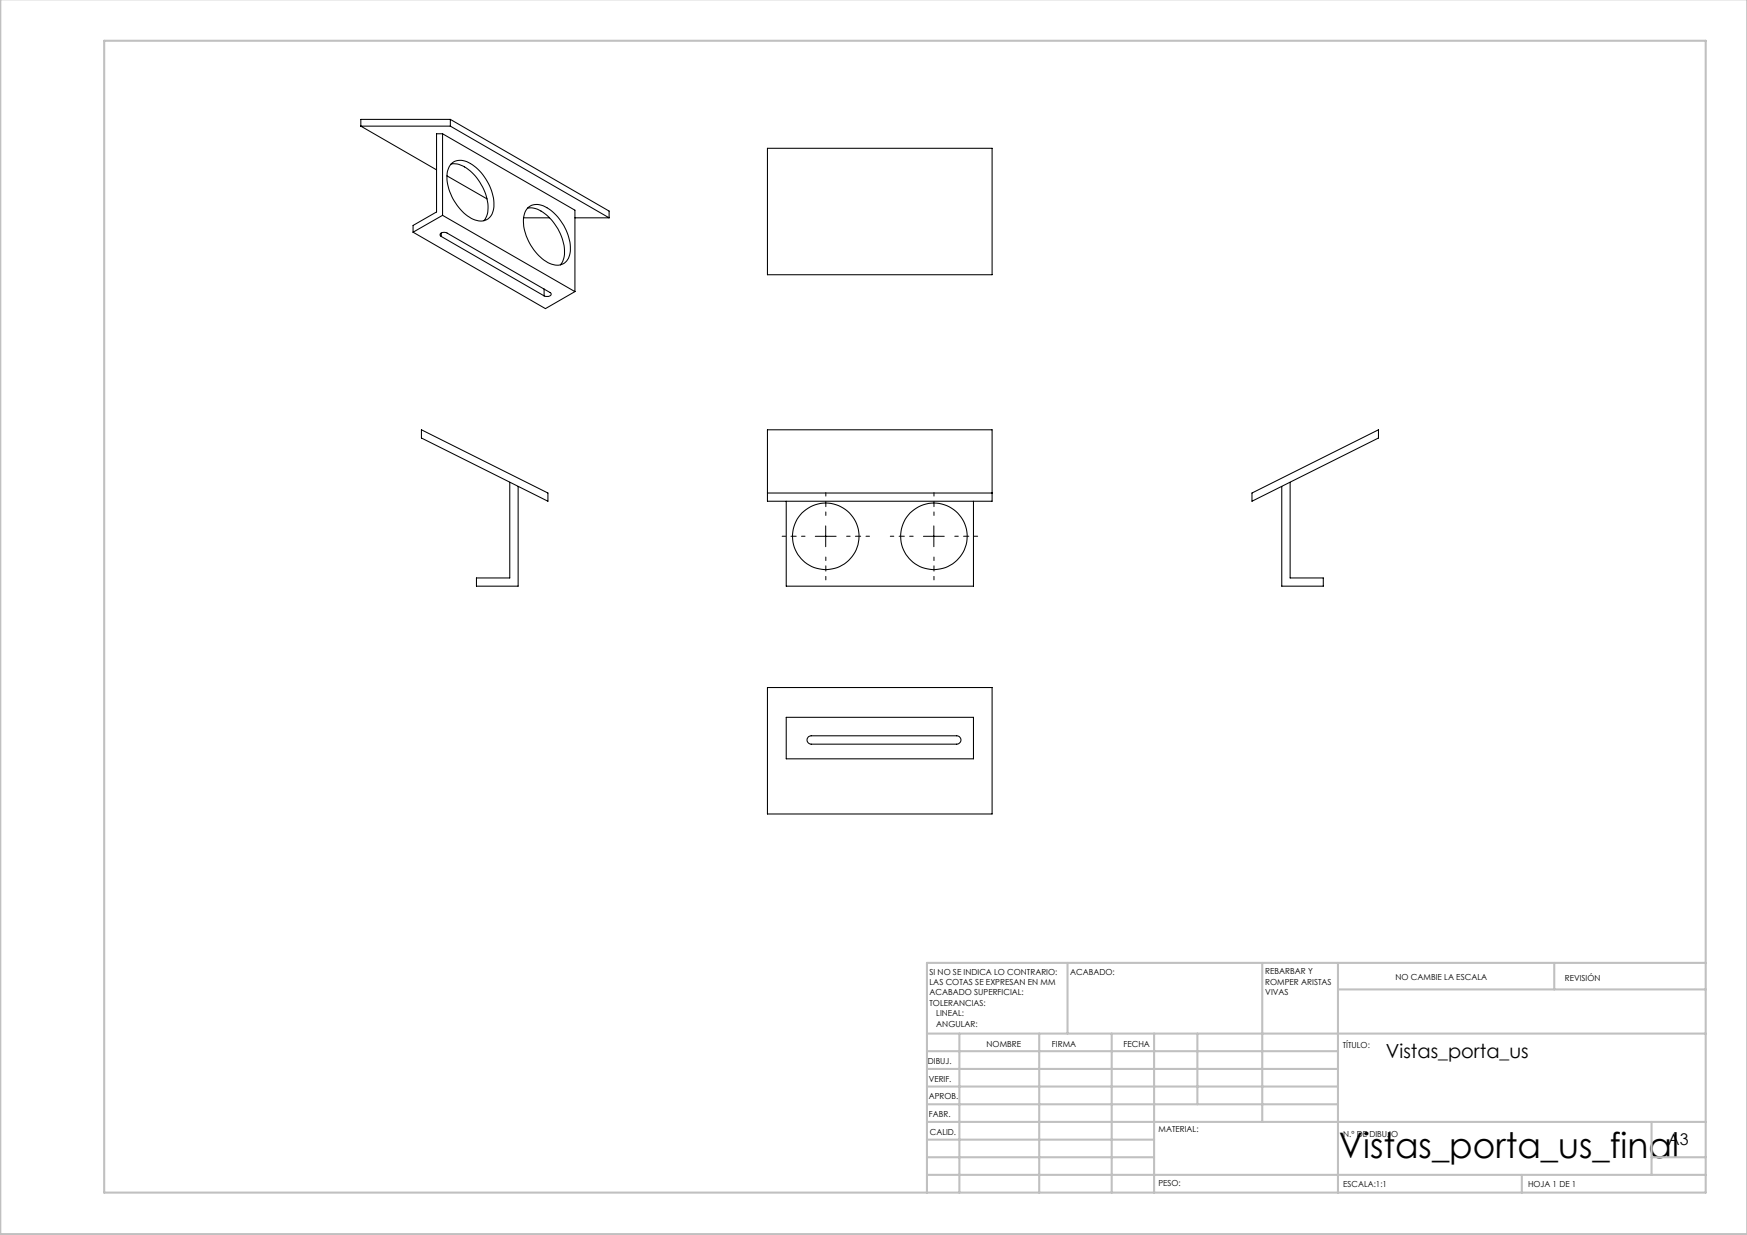
[picture p81: page 13]
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

LAS COTAS SE EXPRESAN EN MM
ACABADO SUPERFICIAL:
TOLERANCIAS:
LINEAL:
ANGULAR:

NOMBRE | FIRMA | FECHA | | | TÍTULO: Vistas_porta_us

DIBUJ.
VERIF.
APROB.
FABR.

MATERIAL: | Vistas_porta_us_final PESO:

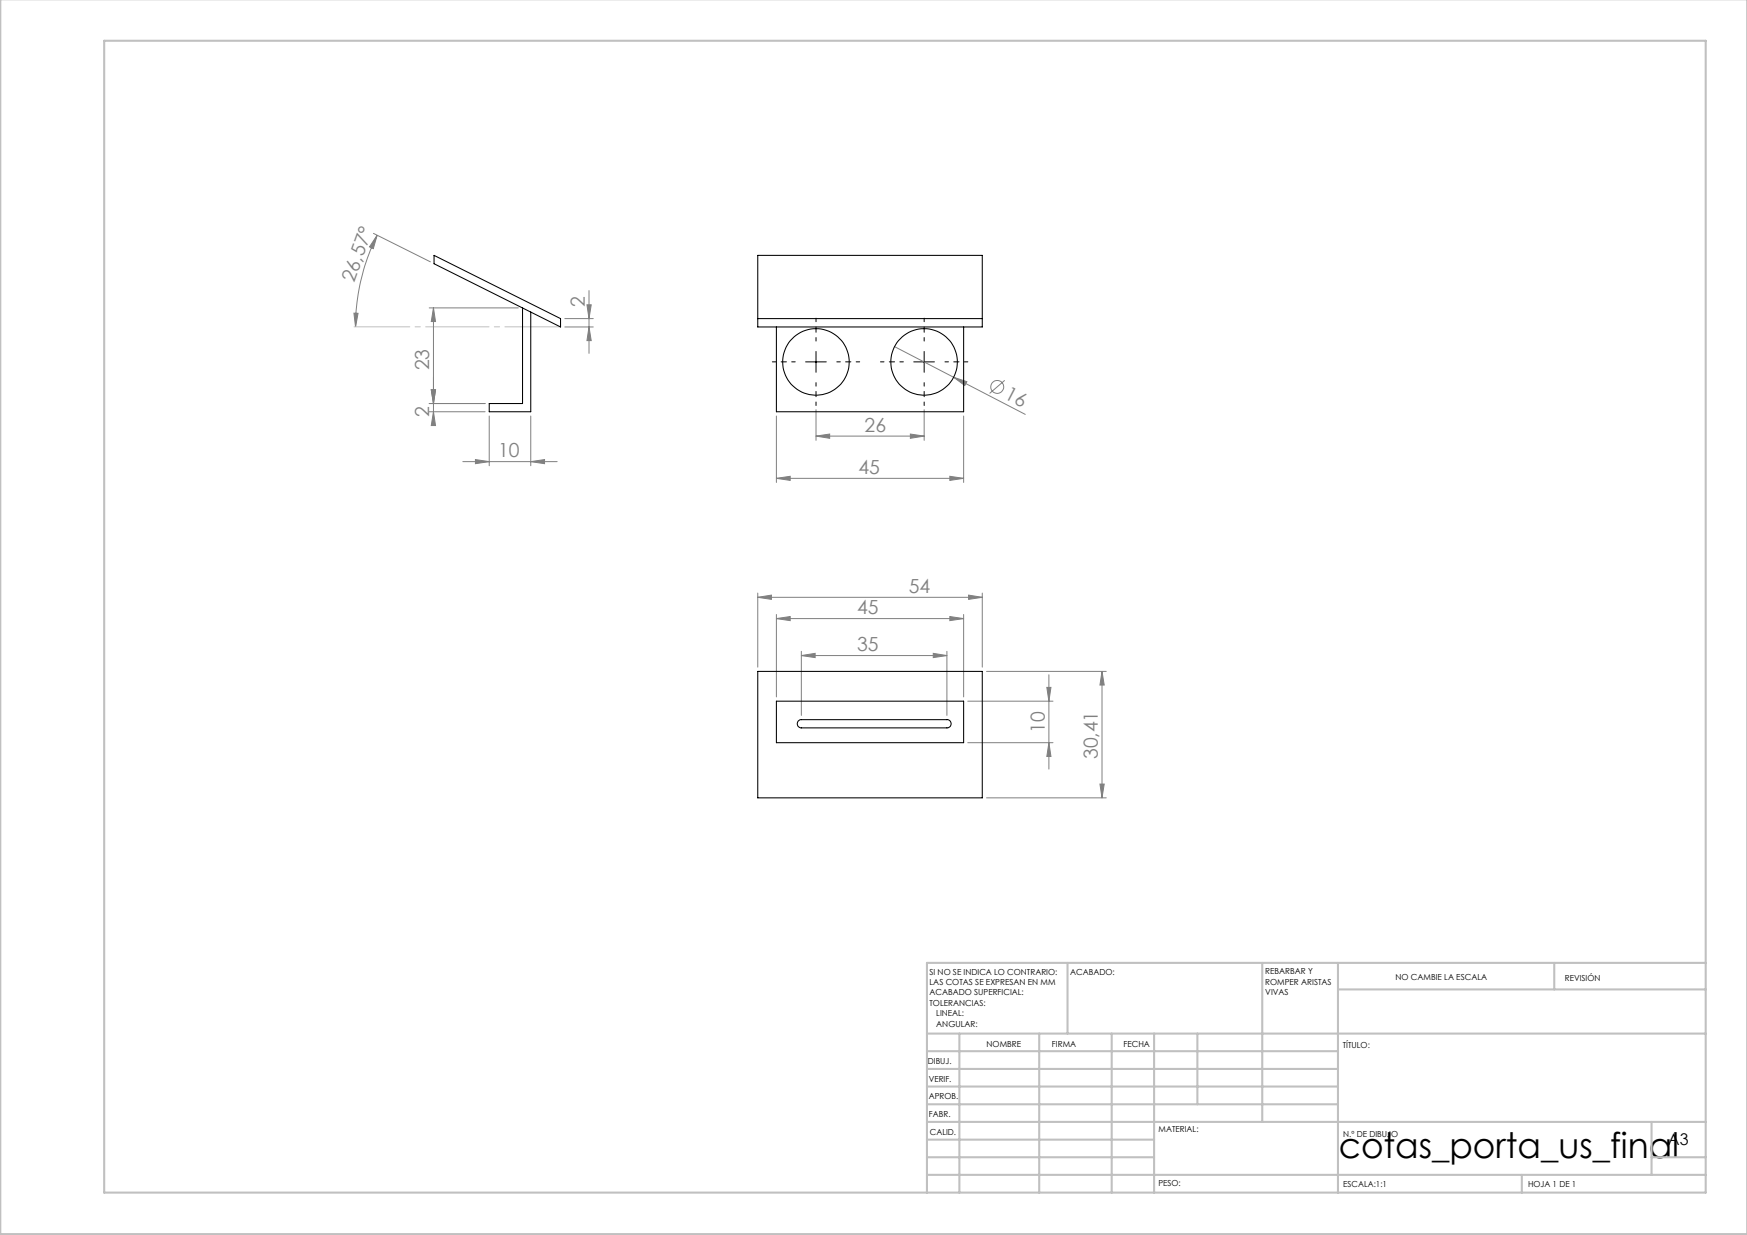
[picture p82: page 14]
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

LAS COTAS SE EXPRESAN EN MM
ACABADO SUPERFICIAL:
TOLERANCIAS:
LINEAL:
ANGULAR:

NOMBRE | FIRMA | FECHA | | | TÍTULO:

DIBUJ.
VERIF.
APROB.
FABR.

MATERIAL: | cotas_porta_us_final PESO:

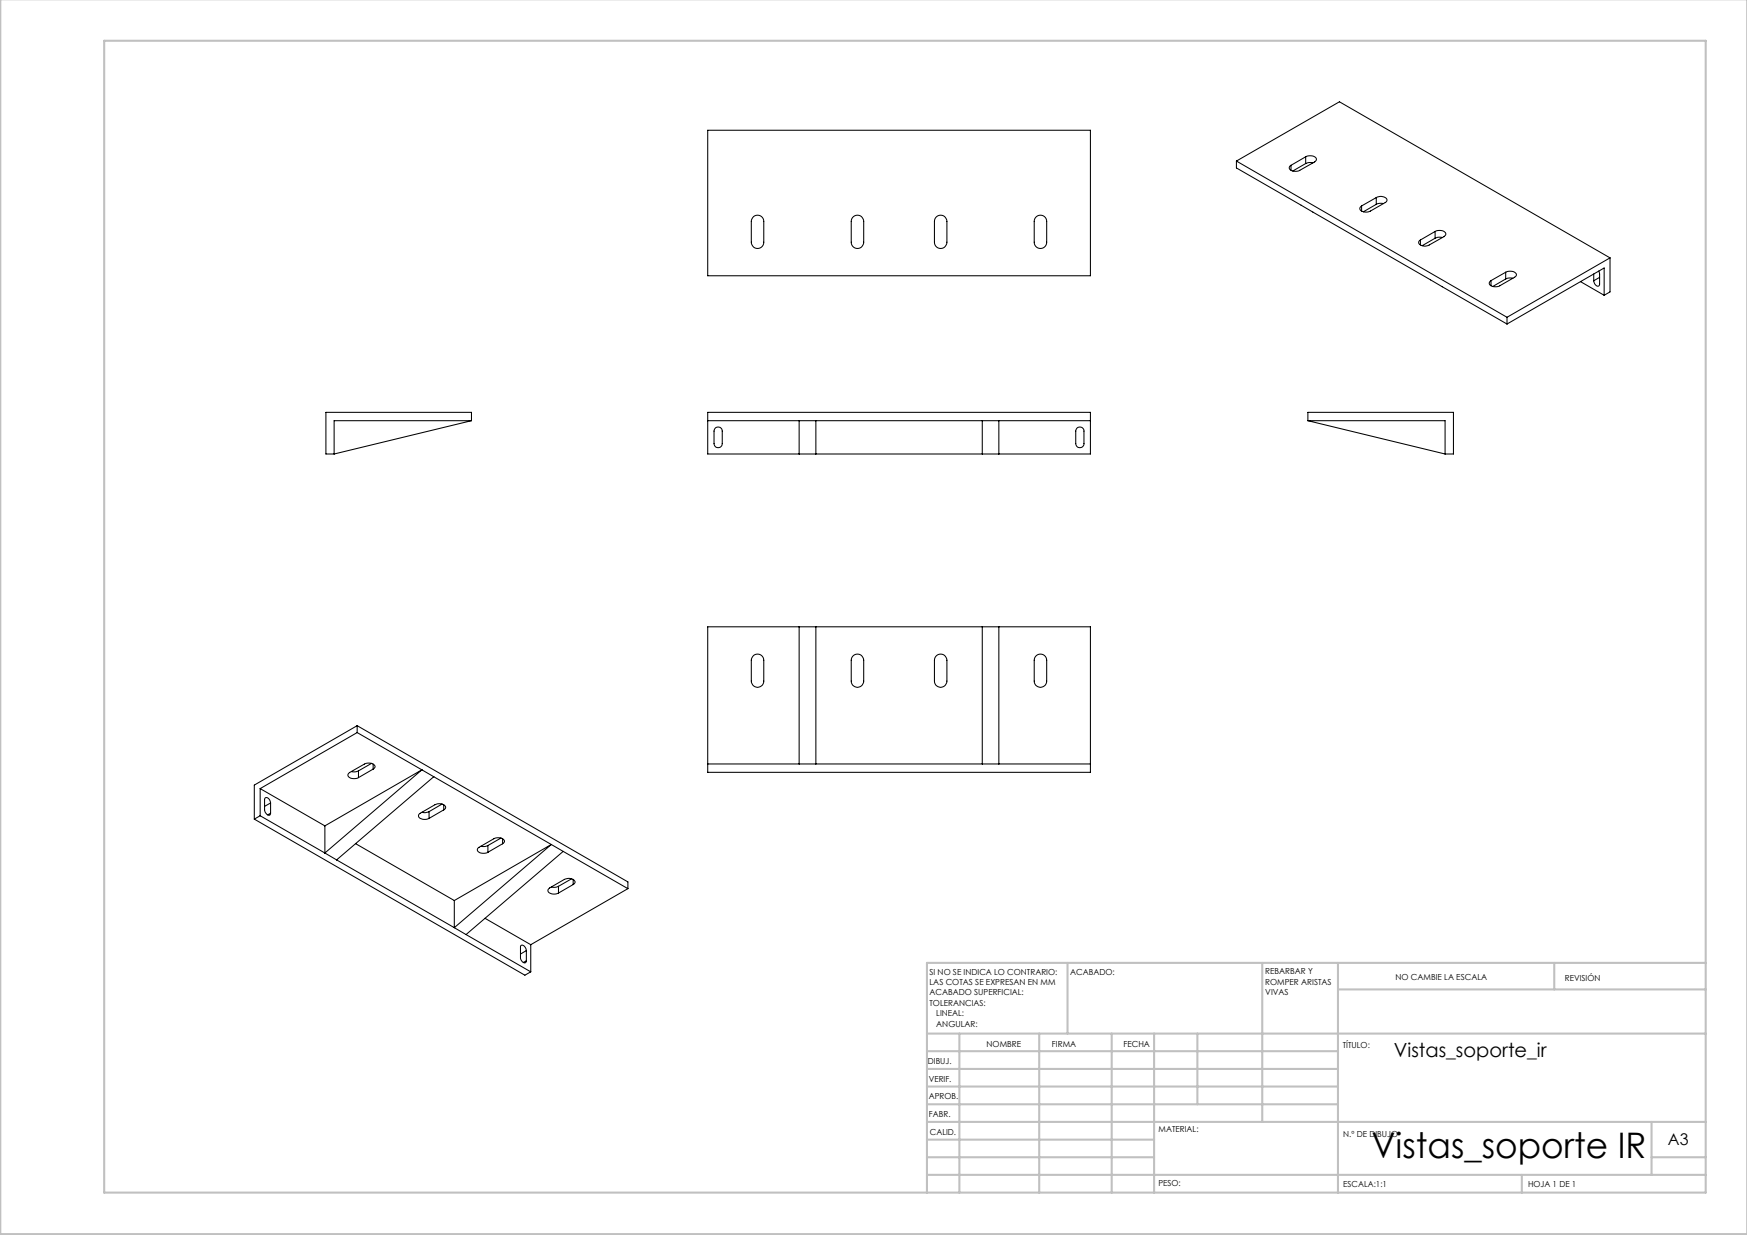
[picture p83: page 15]
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

LAS COTAS SE EXPRESAN EN MM
ACABADO SUPERFICIAL:
TOLERANCIAS:
LINEAL:
ANGULAR:

NOMBRE | FIRMA | FECHA | | | TÍTULO: Vistas_soporte_ir

DIBUJ.
VERIF.
APROB.
FABR.

MATERIAL: | Vistas_soporte IR PESO:

92
35

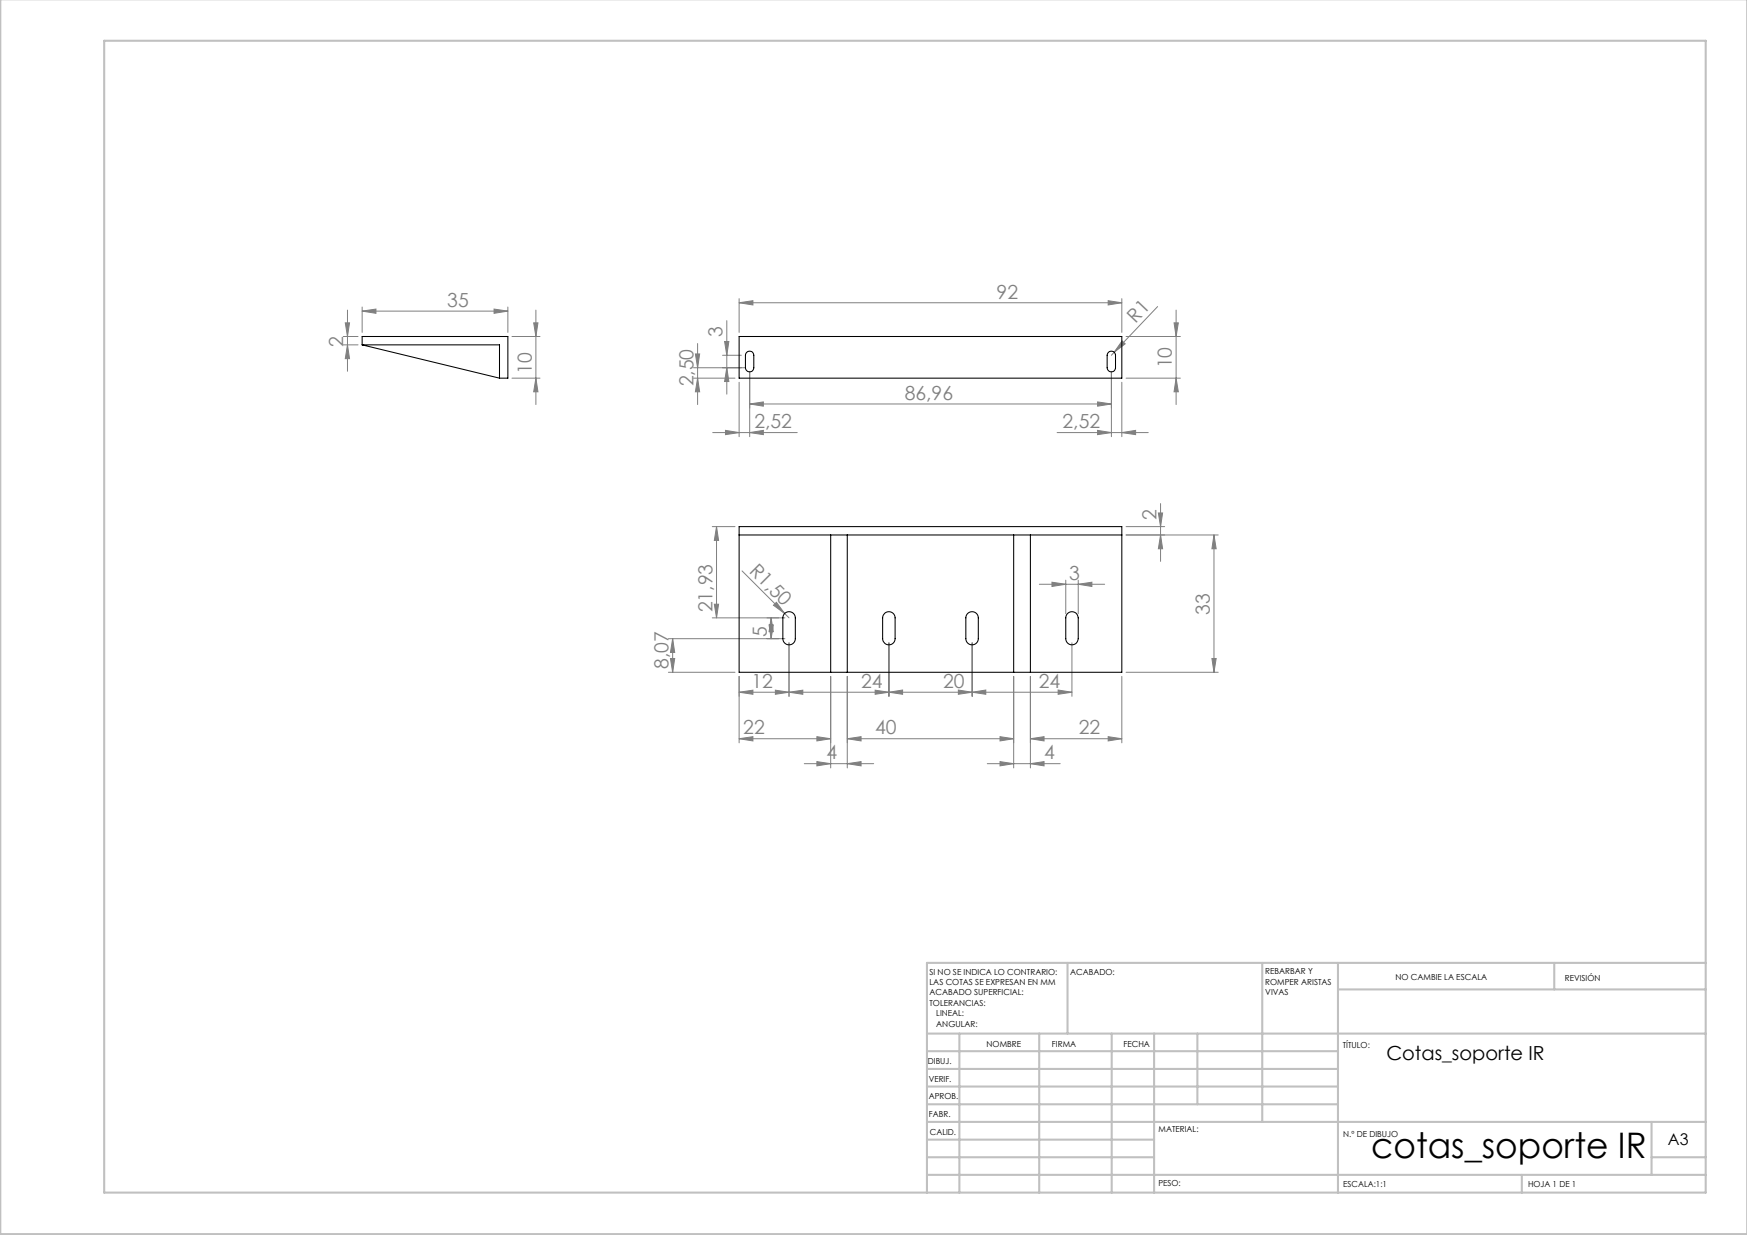
[picture p84: page 16]
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

LAS COTAS SE EXPRESAN EN MM
ACABADO SUPERFICIAL:
TOLERANCIAS:
LINEAL:
ANGULAR:

NOMBRE | FIRMA | FECHA | | | TÍTULO: Cotas_soporte IR

DIBUJ.
VERIF.
APROB.
FABR.

MATERIAL: | cotas_soporte IR PESO:

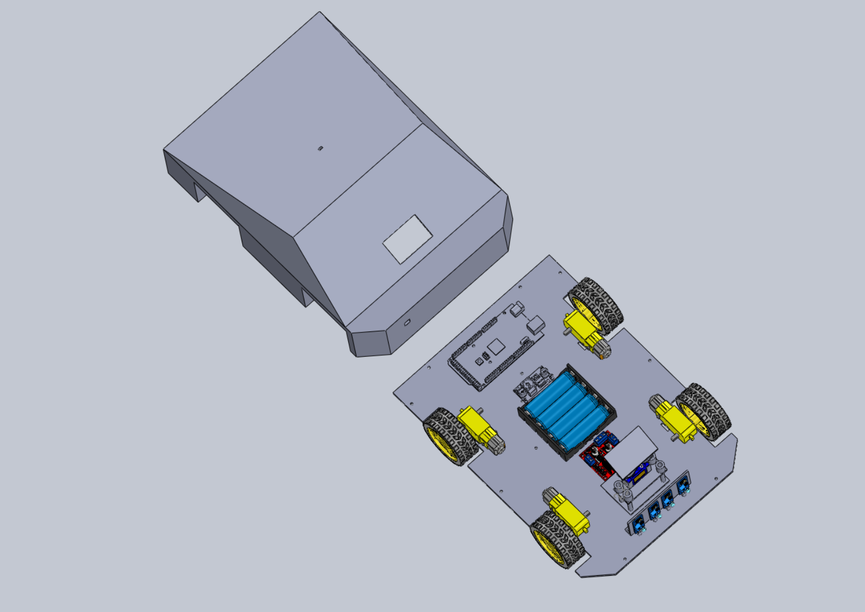
[picture p85: page 17]
